kyonccc/zisaku/pcb/ergogen/footprints/ceoloide/README.md

# ceoloide/ergogen-footprints から取り込んだ部品（MIT ライセンスのみ）

出典: https://github.com/ceoloide/ergogen-footprints （コミット 36a24f5）
ライセンス: MIT（LICENSE-MIT を参照）。販売する製品にも使える。

| ファイル | 用途 |
| --- | --- |
| rotary_encoder_ec11_ec12.js | ロータリーエンコーダー（EC11/EC12） |

> 同じ部品集には Choc スイッチ・nice!view・電源スイッチもあるが、それらは
> **CC-BY-NC-SA-4.0（非営利）** のため kataware では使わず、`../kataware/` に自作したものを使う。
