kyonccc/zisaku/docs/concept/ukishima-ball-19.png

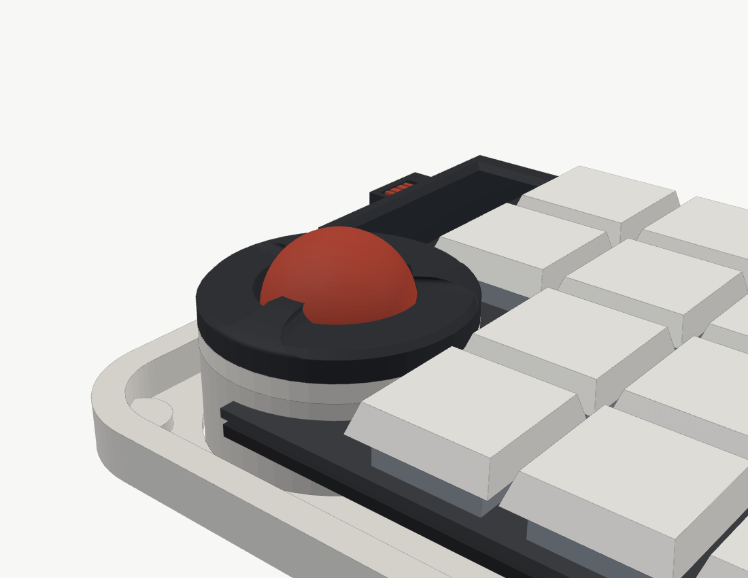
docs/concept/ukishima-ball-19.png
