kyonccc/zisaku/docs/concept/ukishima-ball-34.png

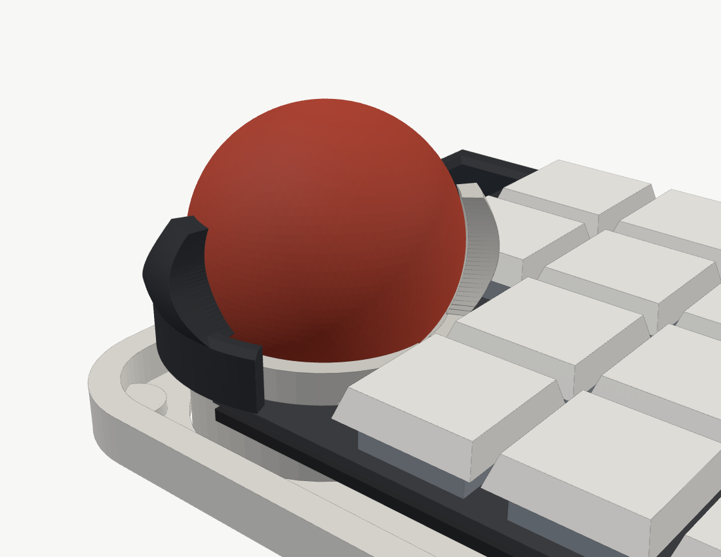
docs/concept/ukishima-ball-34.png
