kyonccc/zisaku/docs/concept/ukishima-ball-side.png

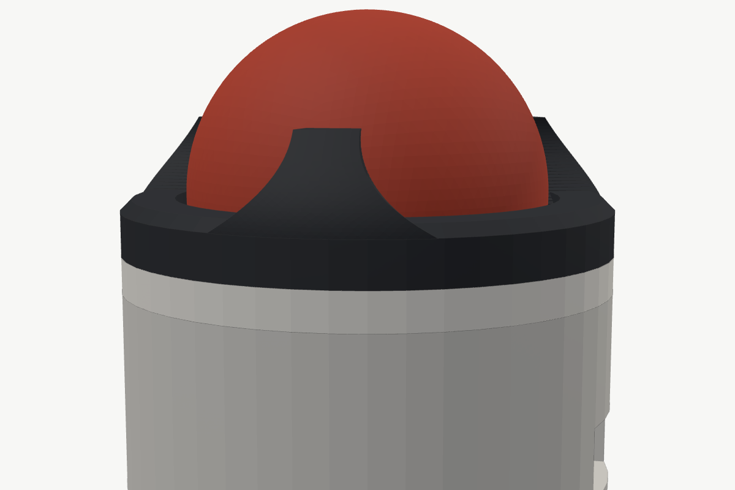
docs/concept/ukishima-ball-side.png
