kyonccc/zisaku/docs/concept/ukishima-screen.png

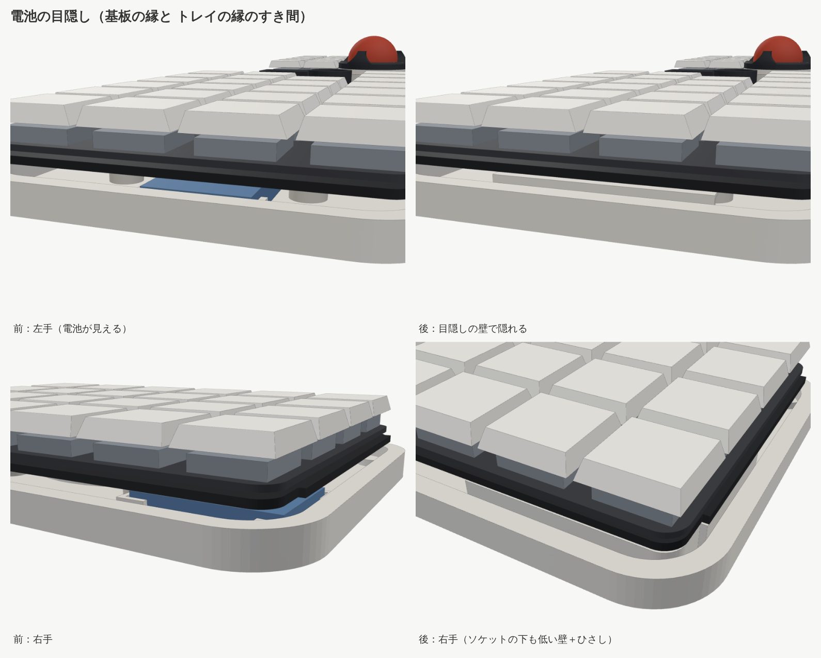
docs/concept/ukishima-screen.png
