kyonccc/zisaku/docs/concept/ukishima-top3d.png

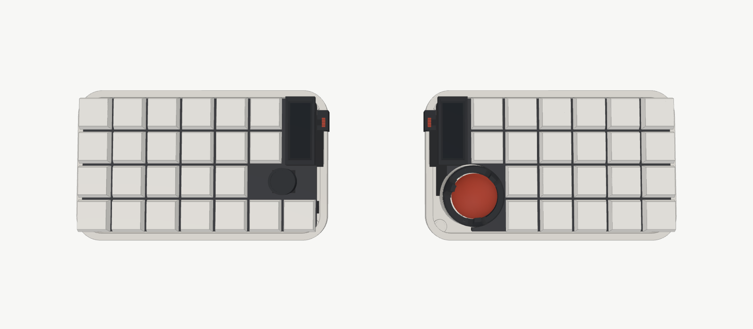
docs/concept/ukishima-top3d.png
