kyonccc/zisaku/docs/concept/ukishima-v1-exploded.png

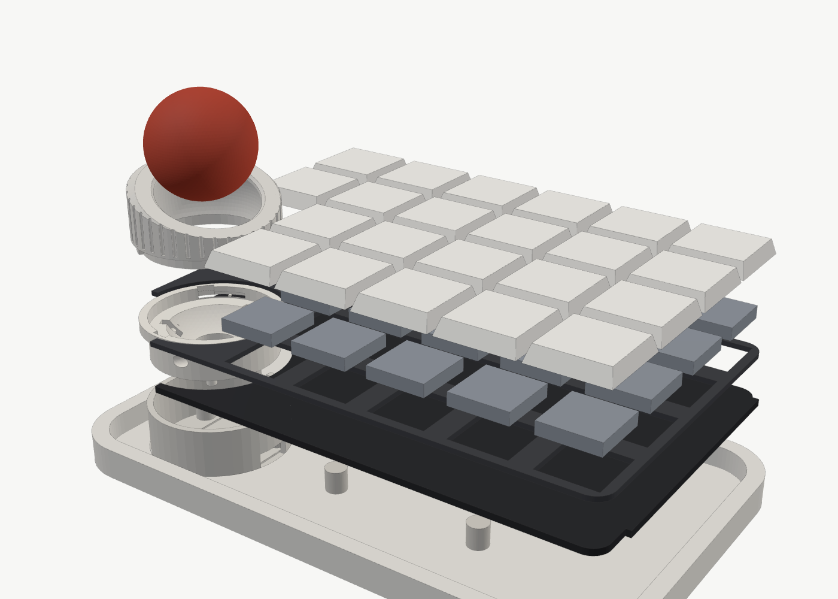
docs/concept/ukishima-v1-exploded.png
