kyonccc/zisaku/docs/concept/ukishima-v1-side.png

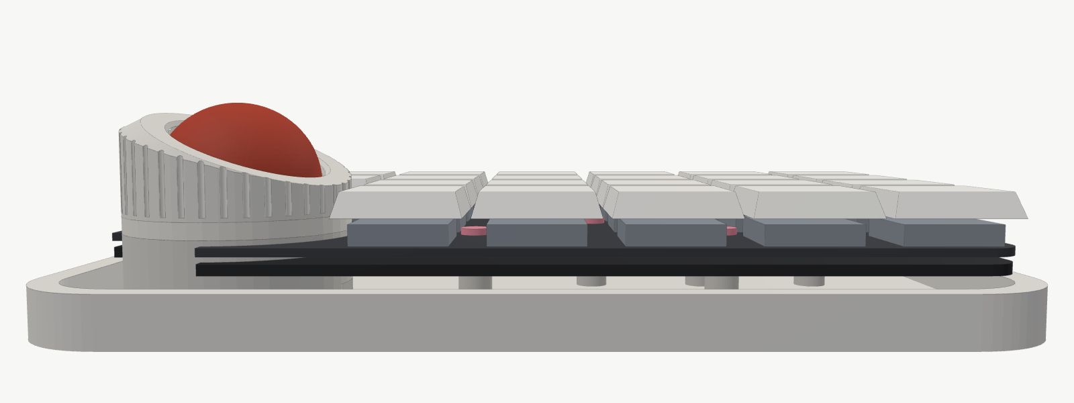
docs/concept/ukishima-v1-side.png
