kyonccc/zisaku/docs/images/ball-60deg-compare.png

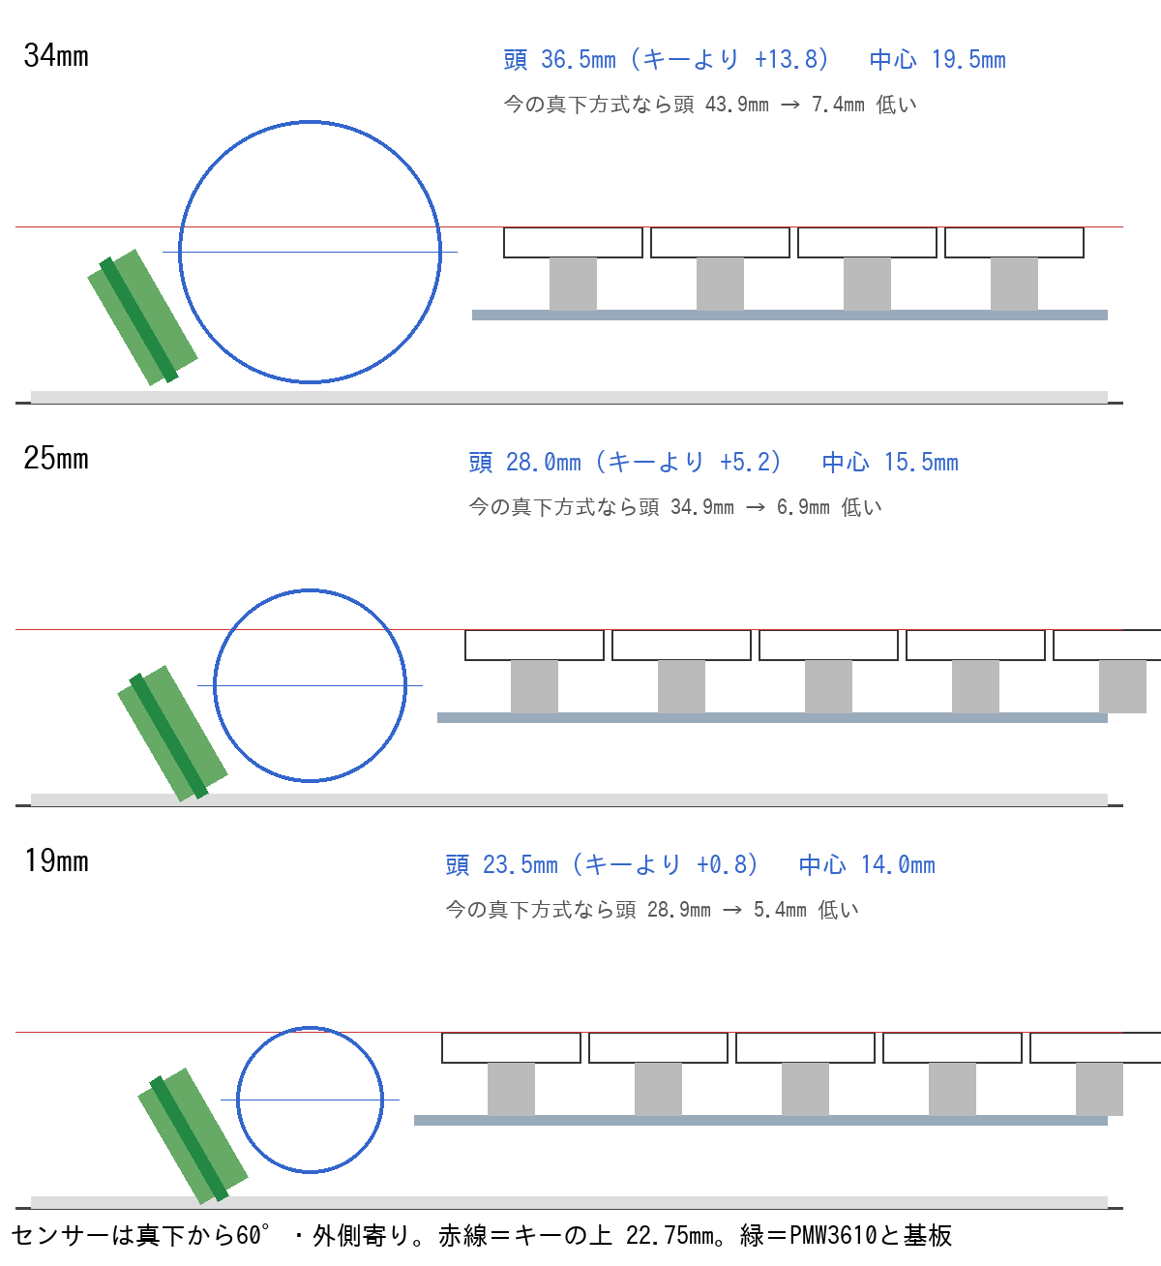
docs/images/ball-60deg-compare.png
