kyonccc/zisaku/docs/images/ball-case-34.png

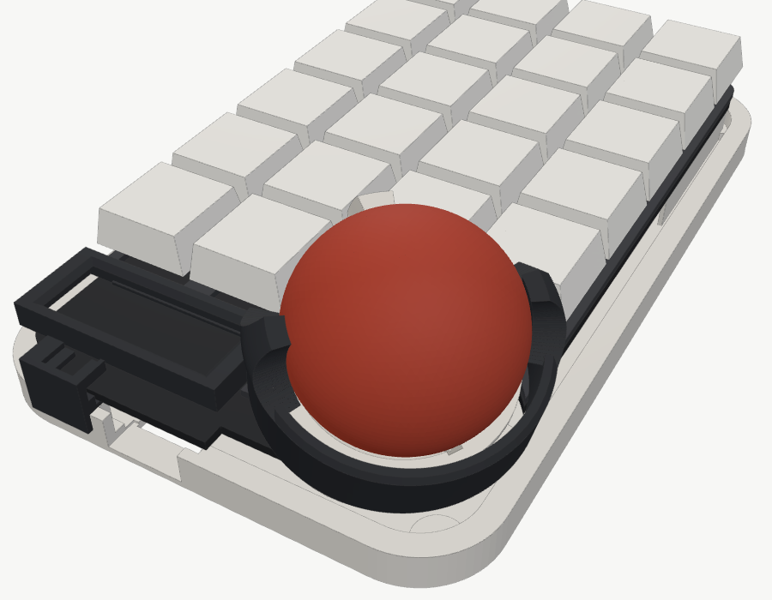
docs/images/ball-case-34.png
