kyonccc/zisaku/docs/images/ball-case-fillet.png

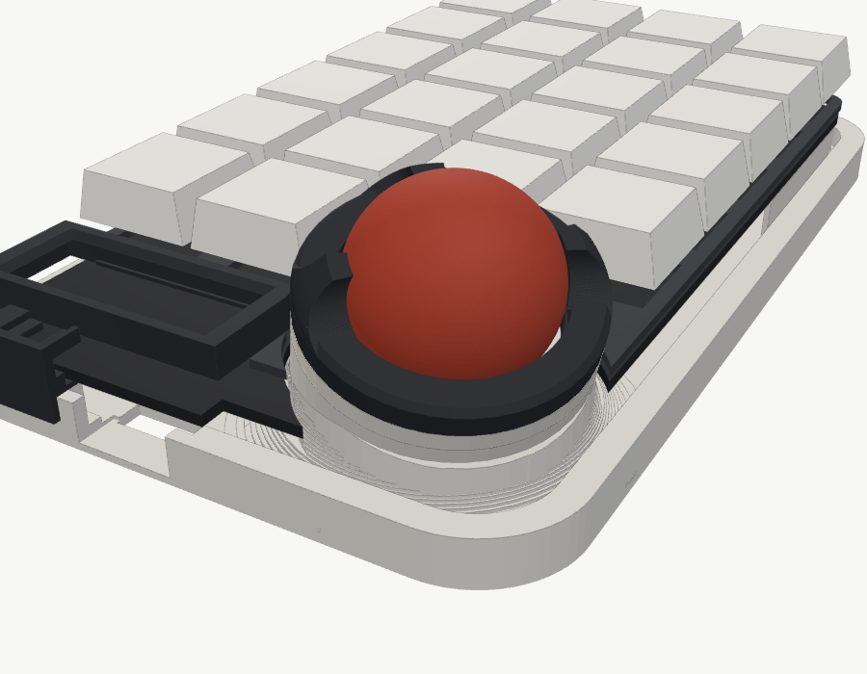
docs/images/ball-case-fillet.png
