kyonccc/zisaku/docs/images/ball-case-new.png

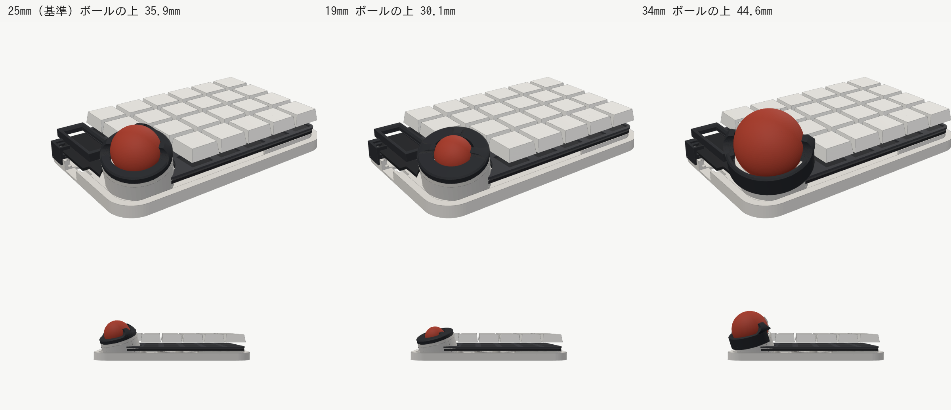
docs/images/ball-case-new.png
