kyonccc/zisaku/docs/images/ball-design-options.png

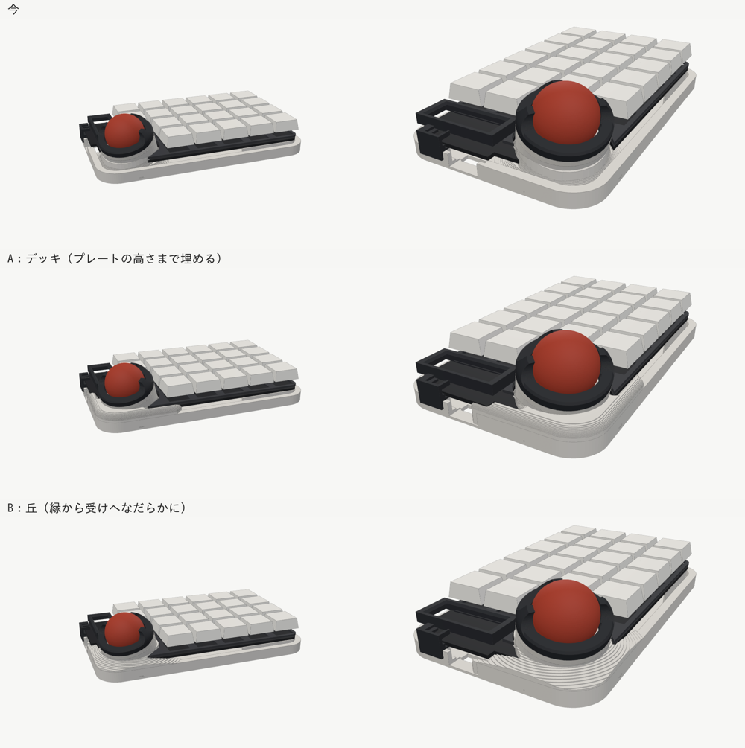
docs/images/ball-design-options.png
