kyonccc/zisaku/docs/images/ball-front-tilt.png

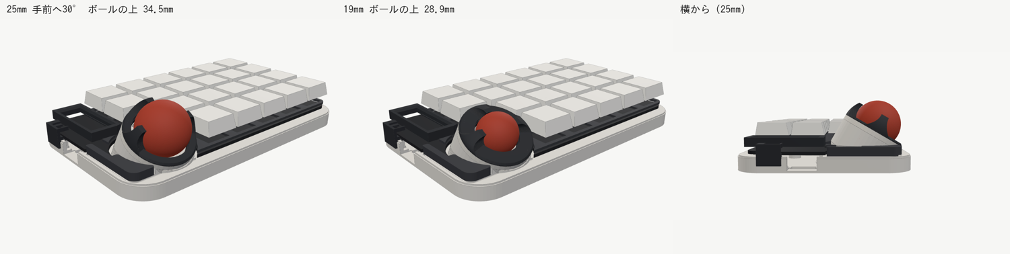
docs/images/ball-front-tilt.png
