kyonccc/zisaku/docs/images/ball-low-rings.png

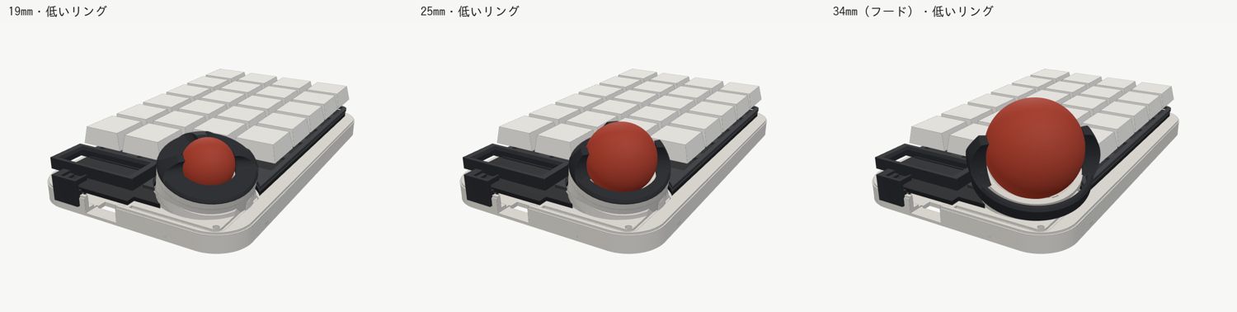
docs/images/ball-low-rings.png
