kyonccc/zisaku/docs/images/ball-tilt-20-30-40.png

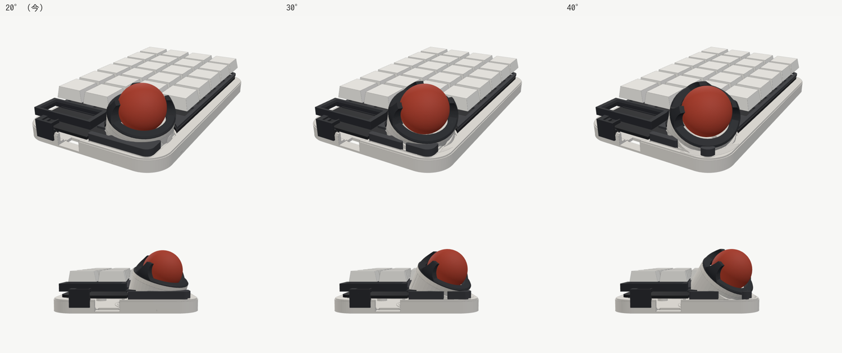
docs/images/ball-tilt-20-30-40.png
