kyonccc/zisaku/docs/images/ball-tilt-30-vs-0.png

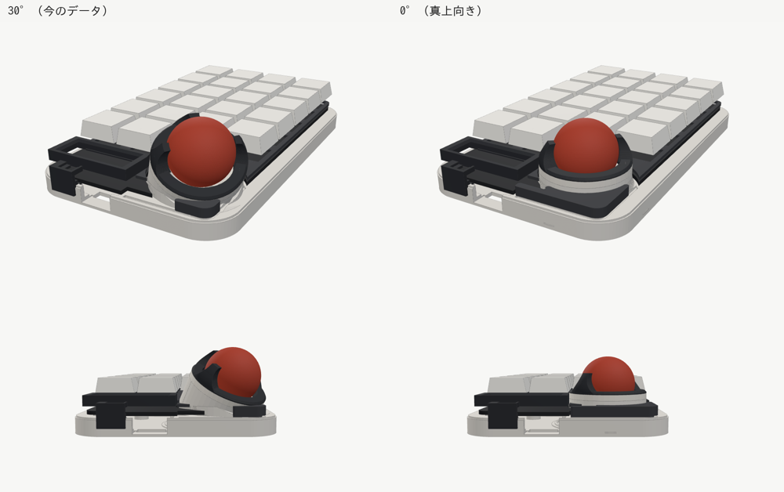
docs/images/ball-tilt-30-vs-0.png
