kyonccc/zisaku/docs/images/case-bottom.png

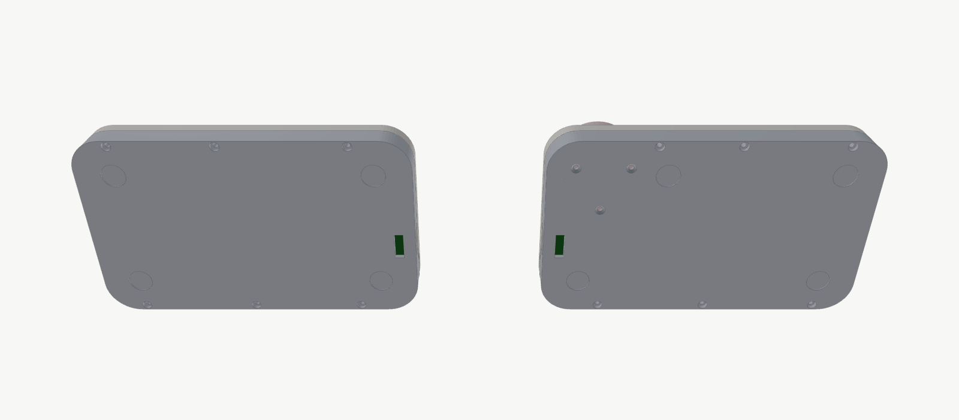
docs/images/case-bottom.png
