kyonccc/zisaku/docs/images/case-exploded-right.png

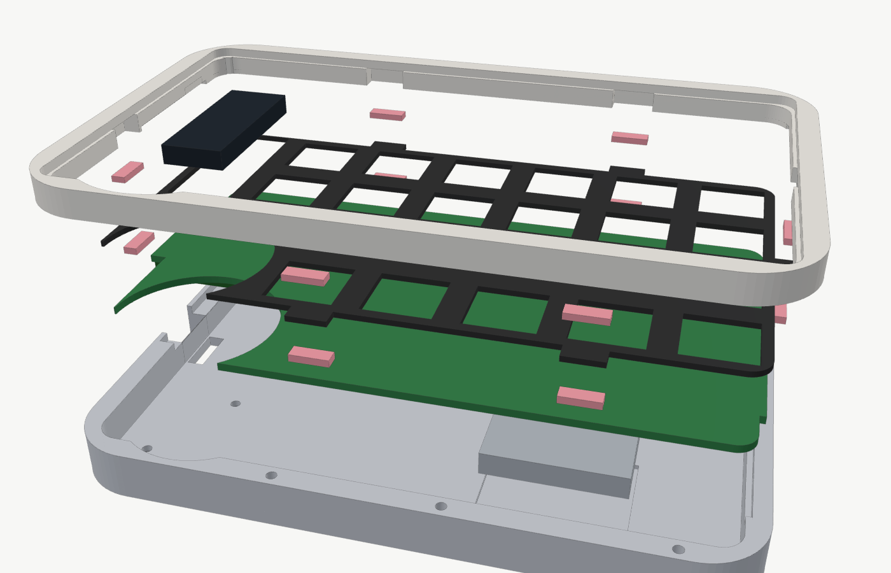
docs/images/case-exploded-right.png
