kyonccc/zisaku/docs/images/concept-ball-module.png

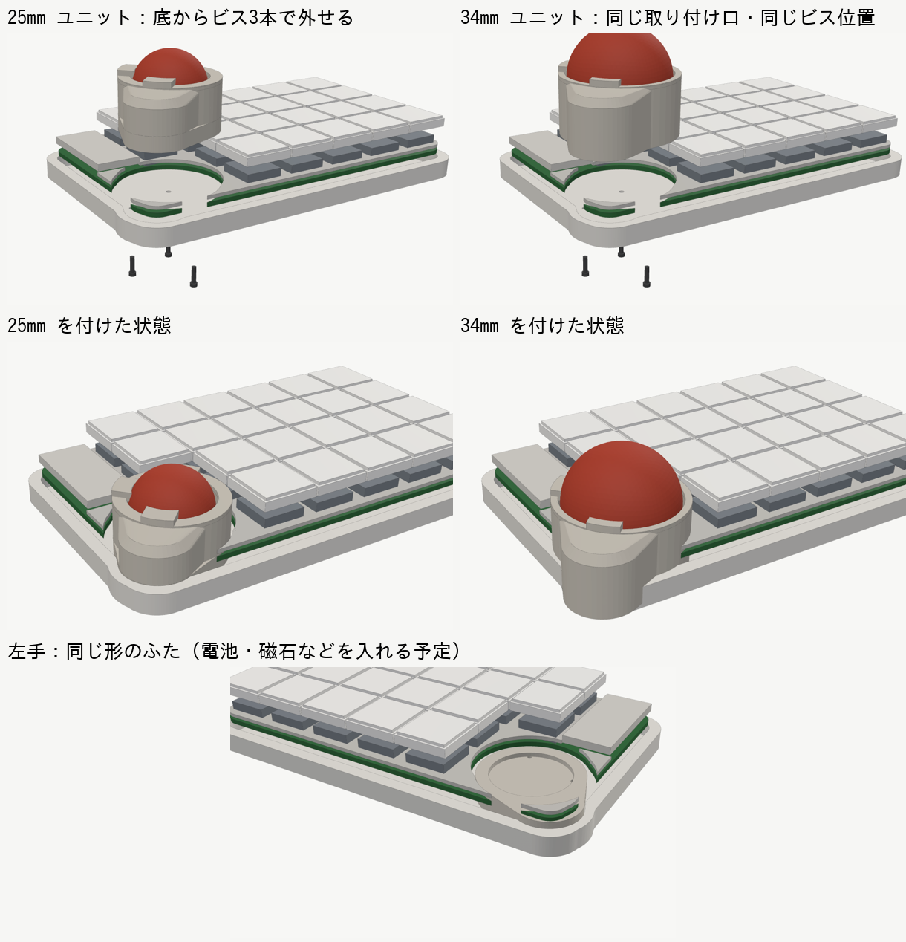
docs/images/concept-ball-module.png
