kyonccc/zisaku/docs/images/concept-cup-screws.png

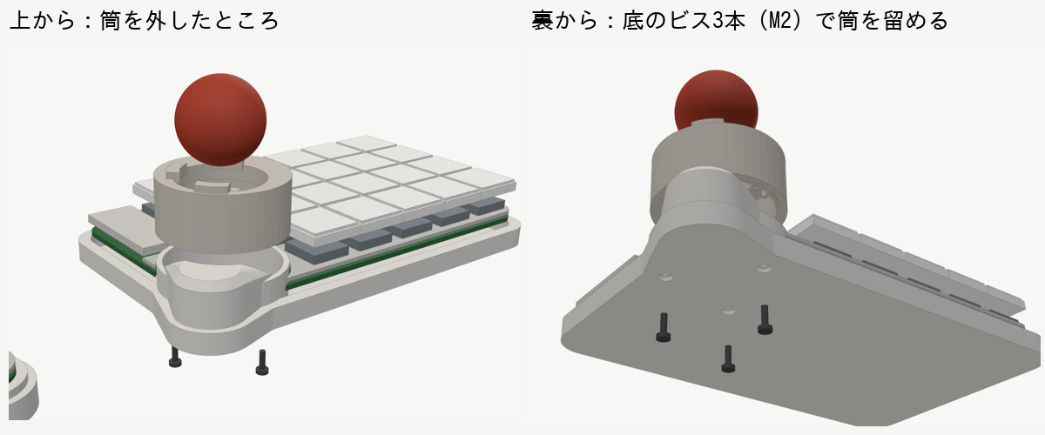
docs/images/concept-cup-screws.png
