kyonccc/zisaku/docs/images/concept-cup-swap.png

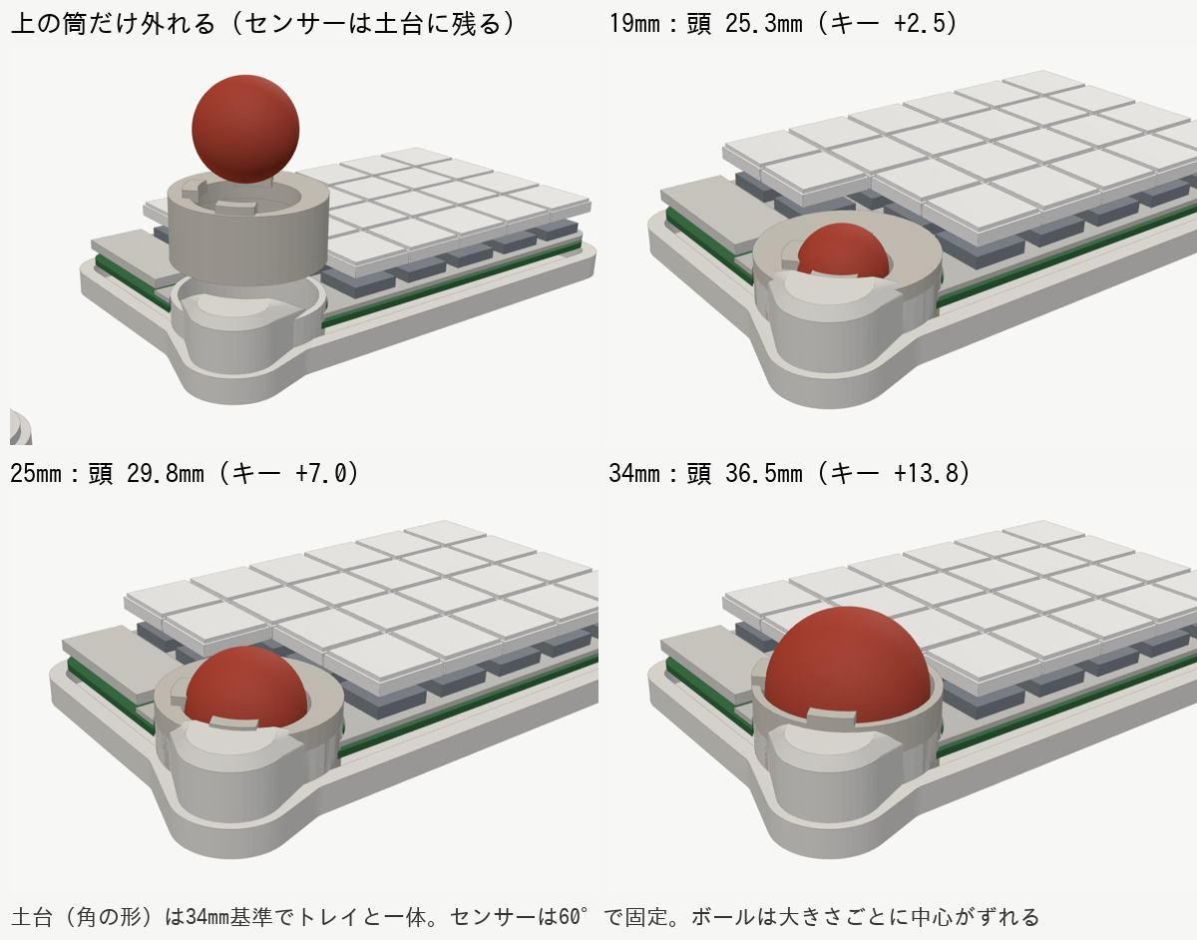
docs/images/concept-cup-swap.png
