kyonccc/zisaku/docs/images/concept-left-wheel.png

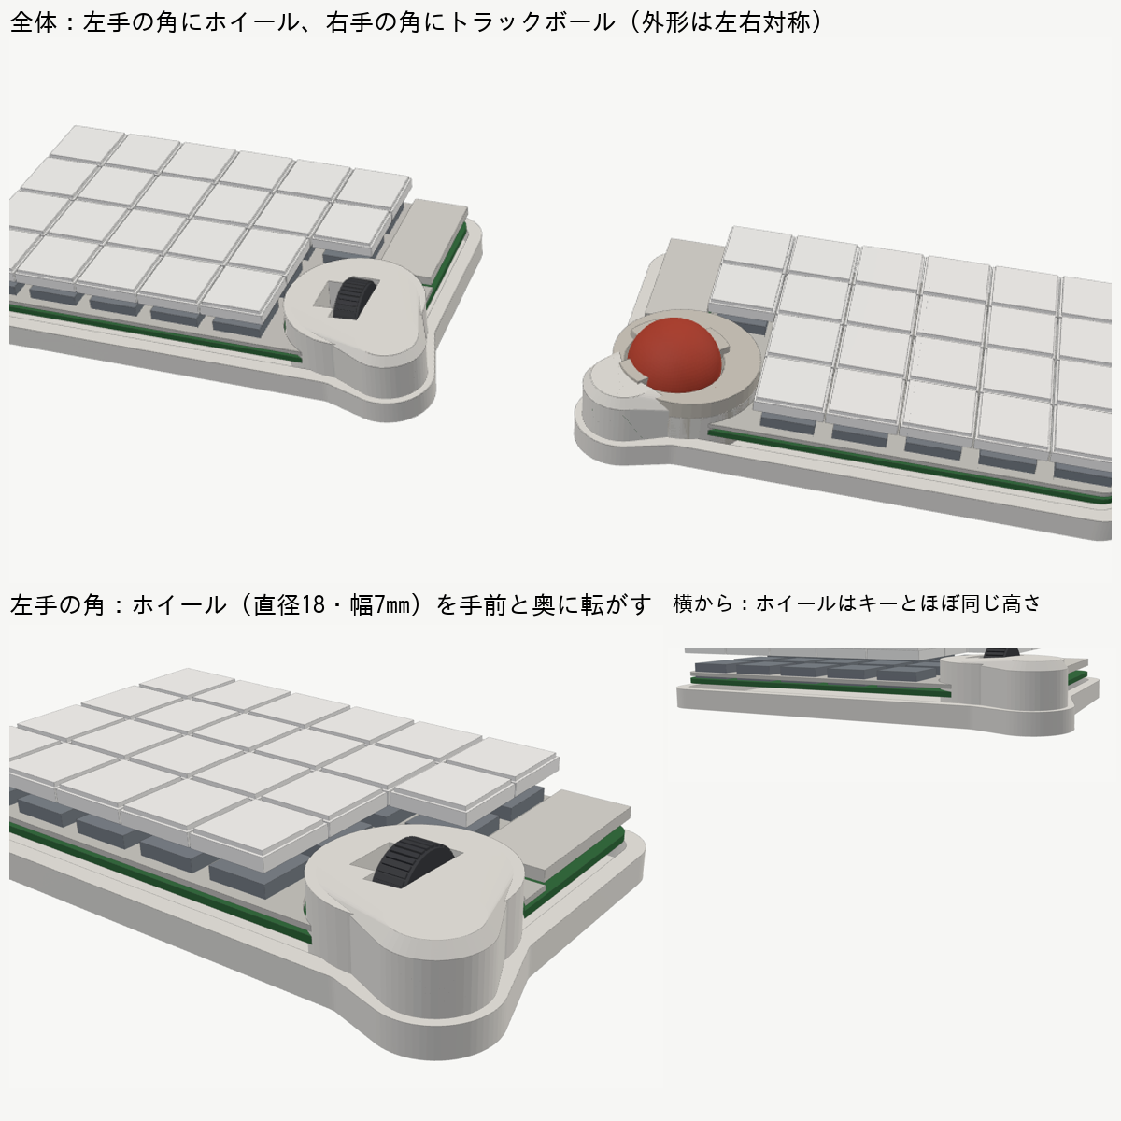
docs/images/concept-left-wheel.png
