kyonccc/zisaku/docs/images/concept-mcu-top.png

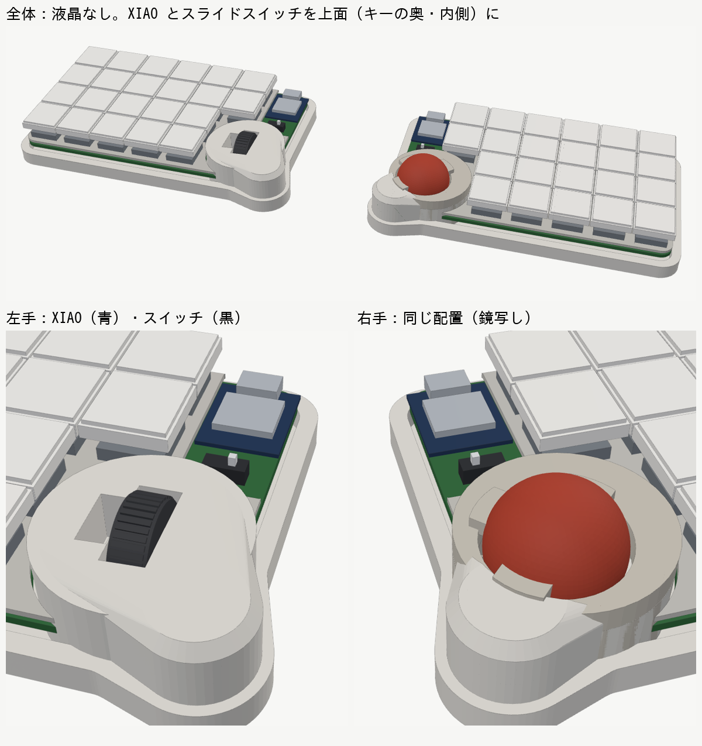
docs/images/concept-mcu-top.png
