kyonccc/zisaku/docs/images/concept-ortho-60deg-34.png

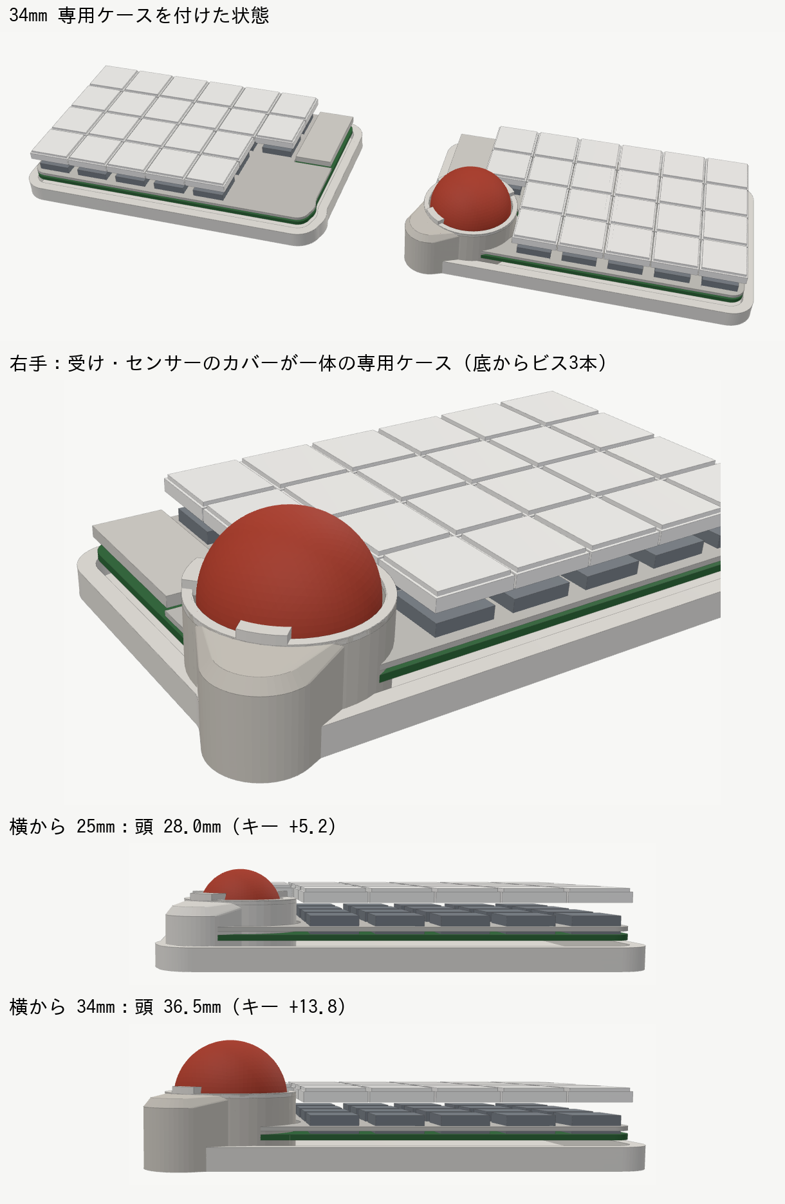
docs/images/concept-ortho-60deg-34.png
