kyonccc/zisaku/docs/images/concept-ortho-60deg.png

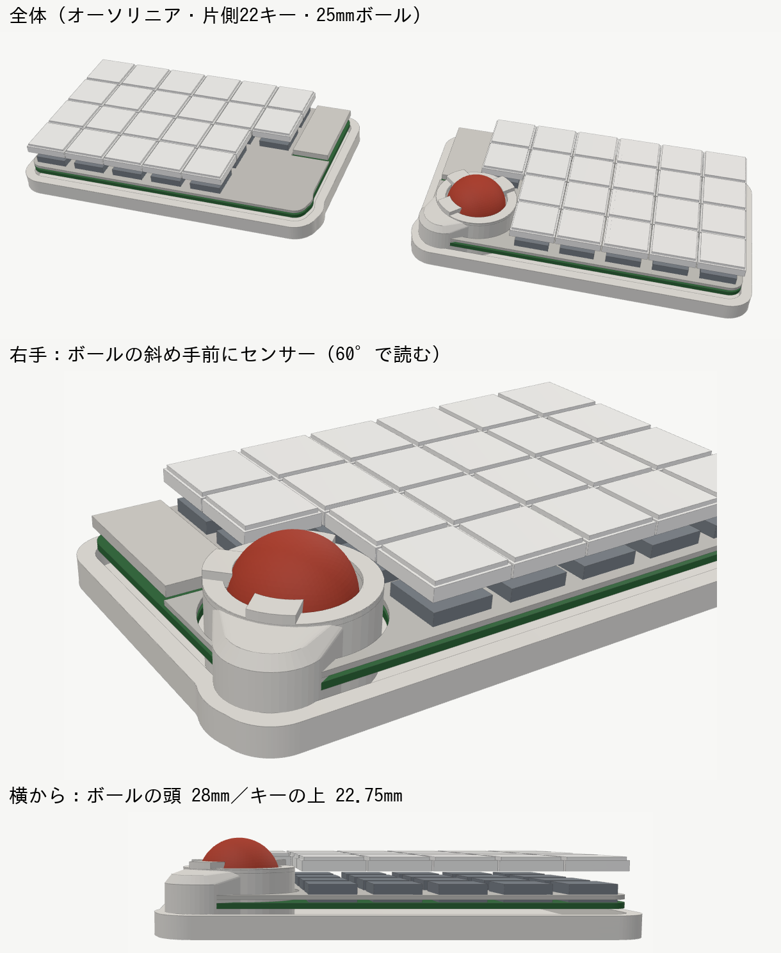
docs/images/concept-ortho-60deg.png
