kyonccc/zisaku/docs/images/concept-tray-small.png

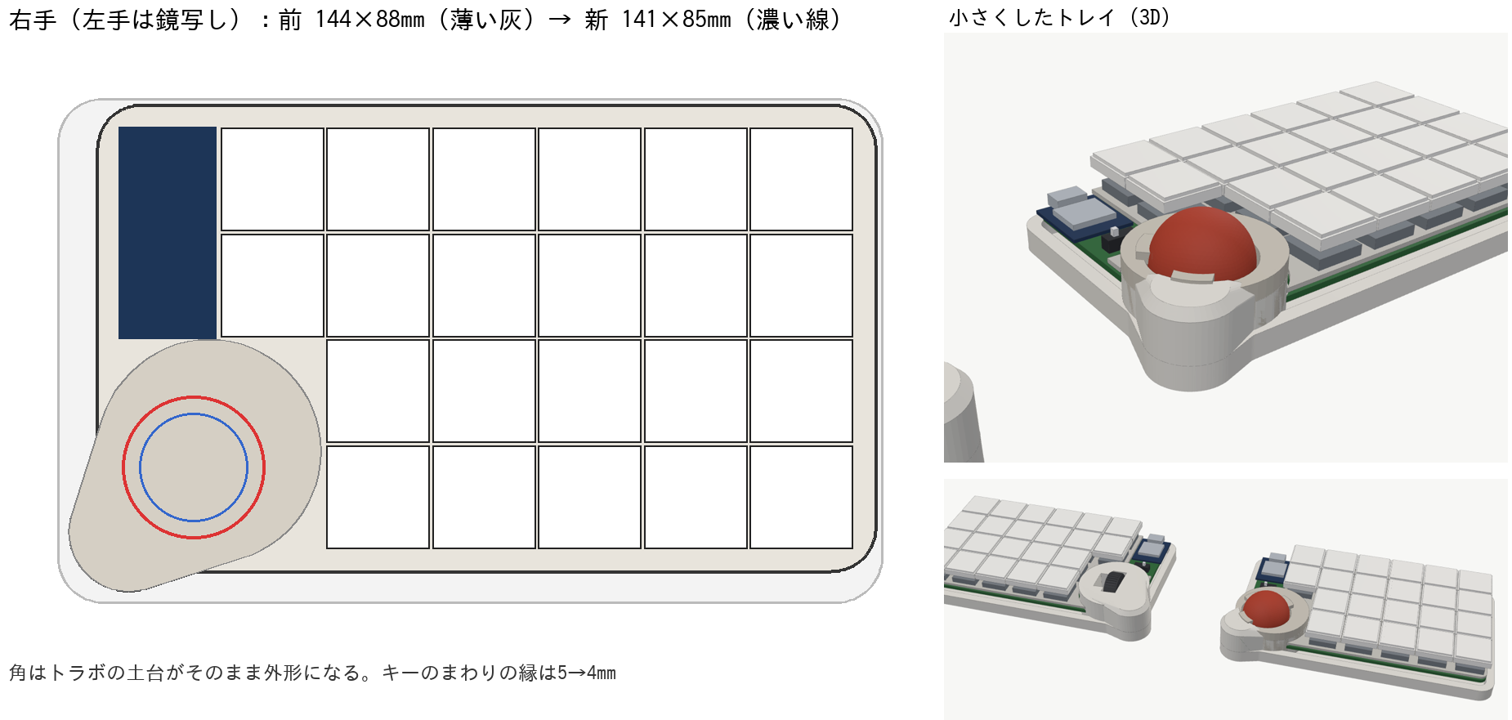
docs/images/concept-tray-small.png
