kyonccc/zisaku/docs/images/controller-section.png

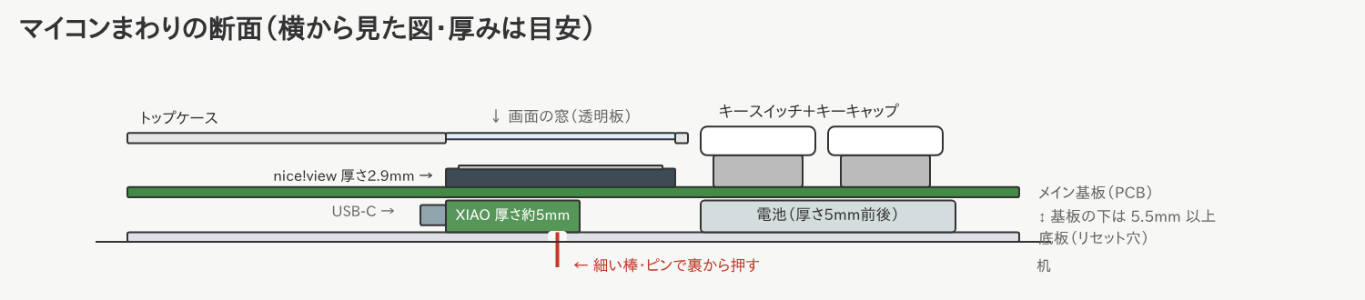
docs/images/controller-section.png
