kyonccc/zisaku/docs/images/controller-top.png

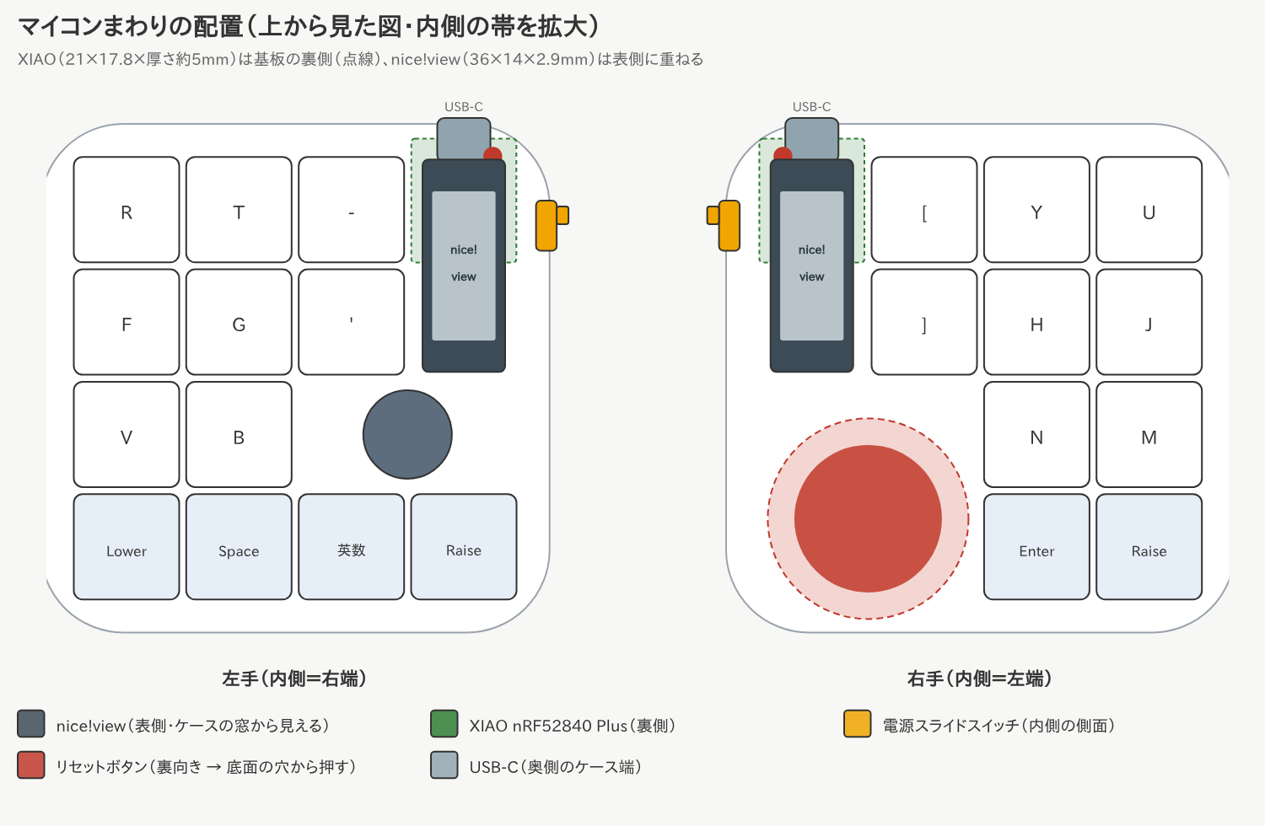
docs/images/controller-top.png
