kyonccc/zisaku/docs/images/island-ball.png

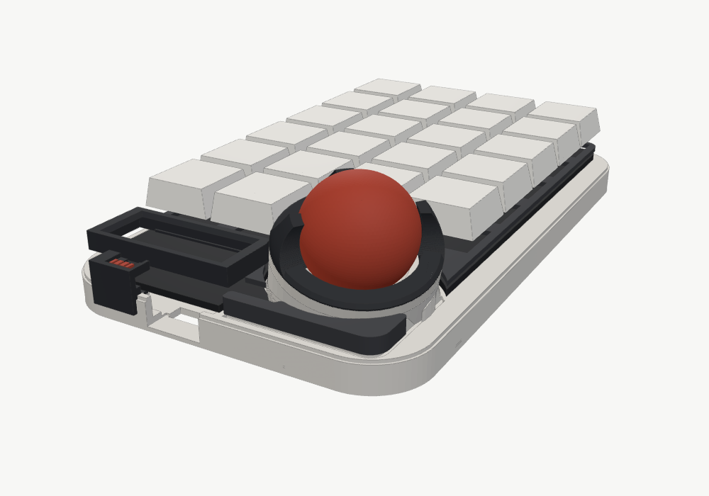
docs/images/island-ball.png
