kyonccc/zisaku/docs/images/island-overview.png

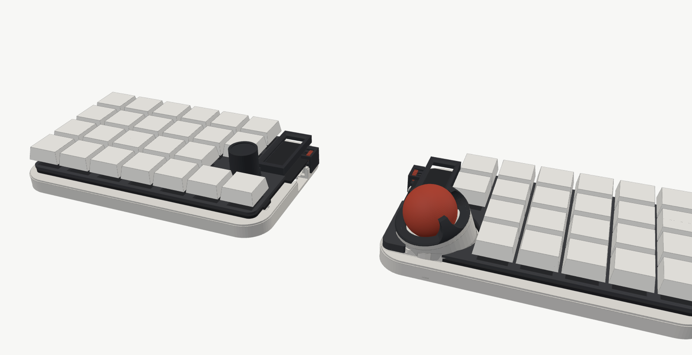
docs/images/island-overview.png
