kyonccc/zisaku/docs/images/island-side.png

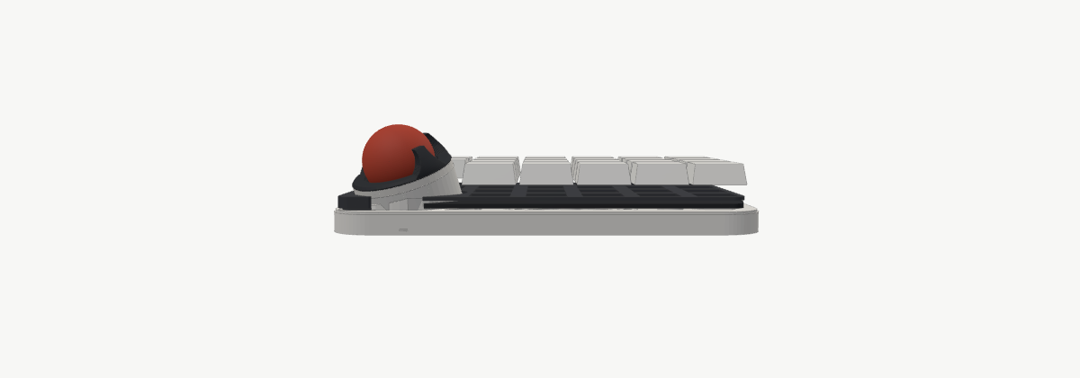
docs/images/island-side.png
