kyonccc/zisaku/docs/images/layout-d-candidates.png

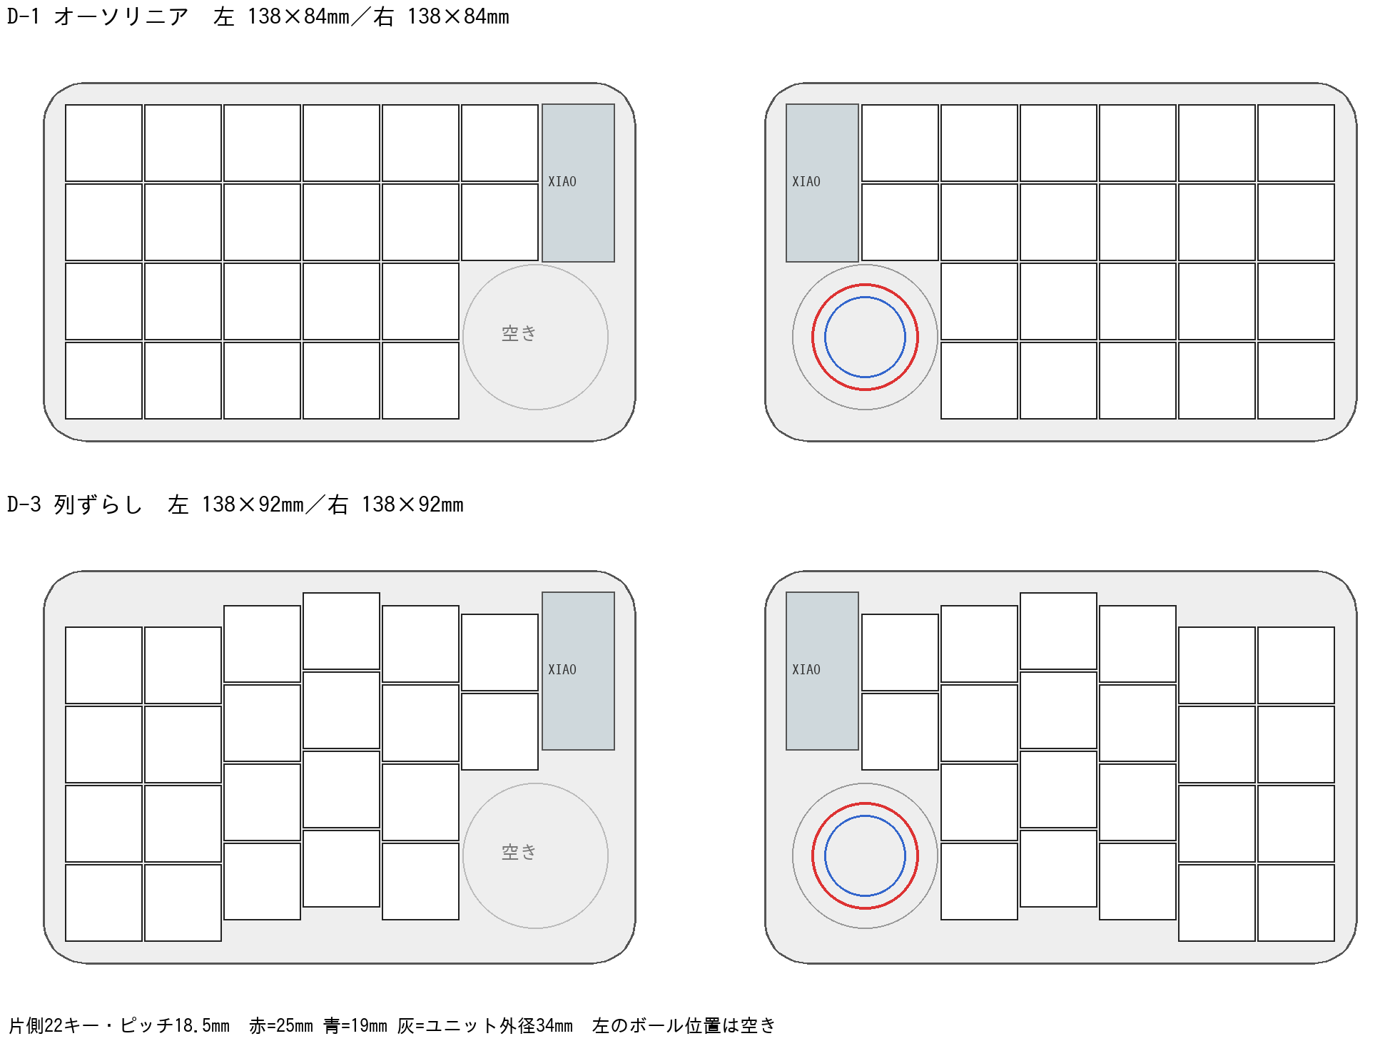
docs/images/layout-d-candidates.png
