kyonccc/zisaku/docs/images/layout-plan1.png

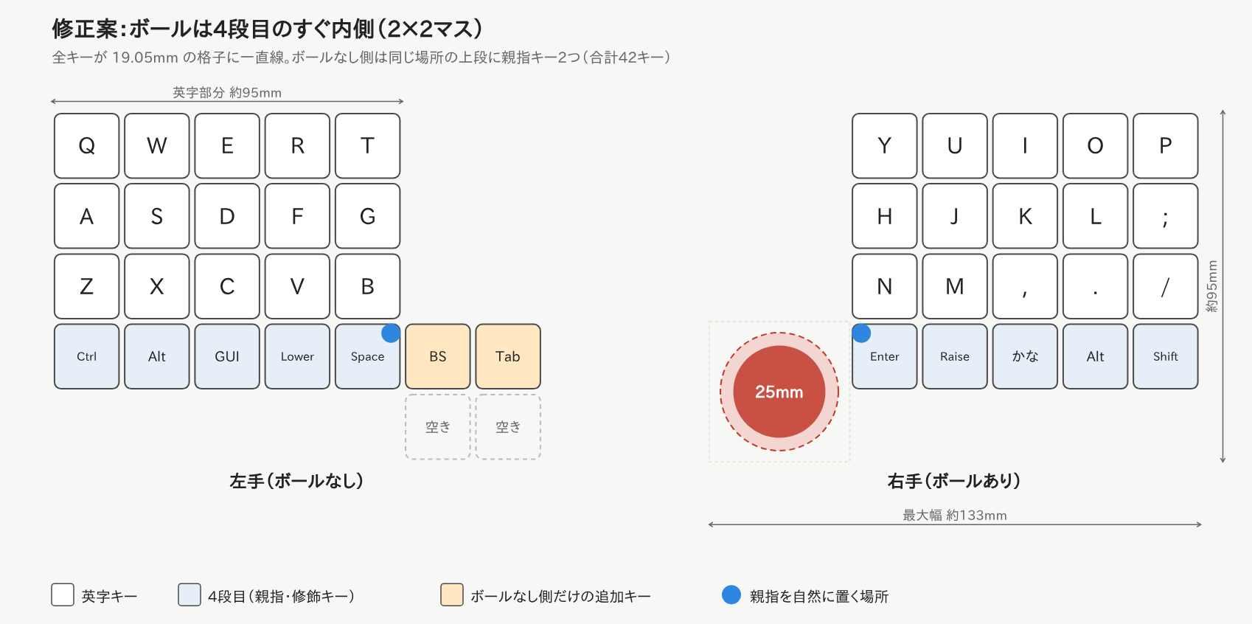
docs/images/layout-plan1.png
