kyonccc/zisaku/docs/images/layout-plan2.png

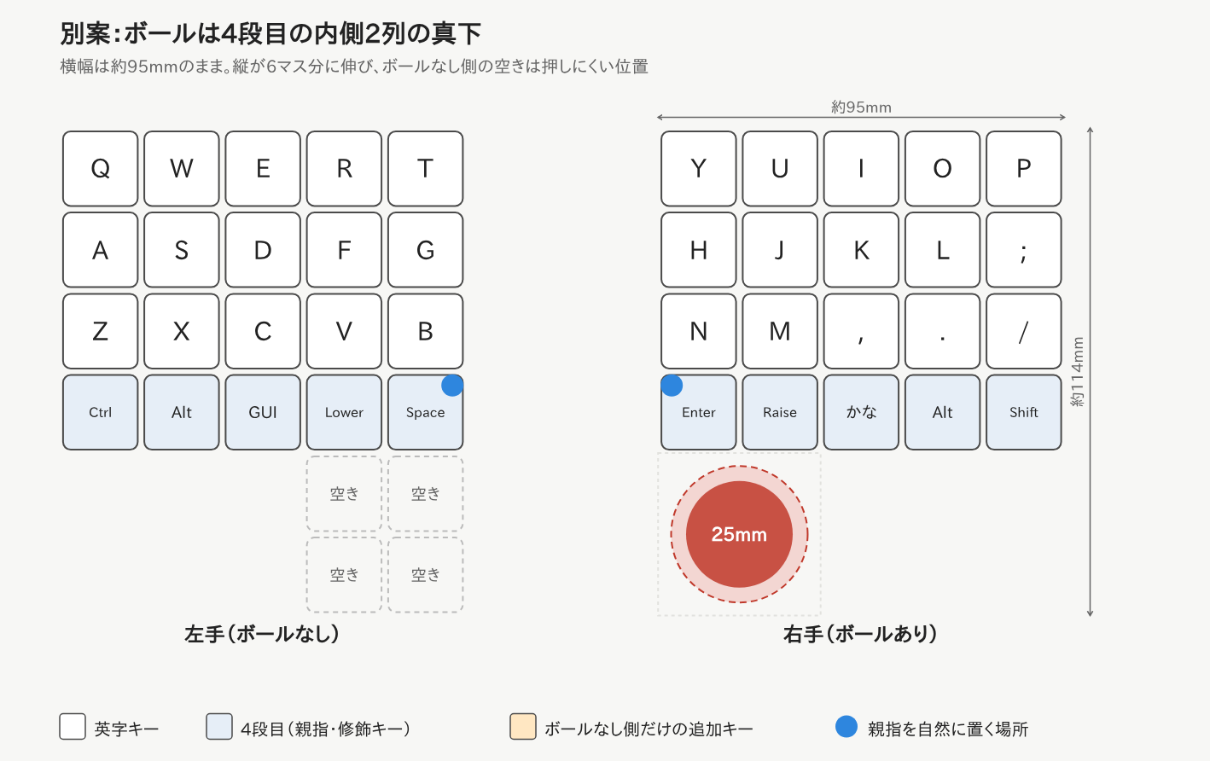
docs/images/layout-plan2.png
