kyonccc/zisaku/docs/images/layout-tidy.png

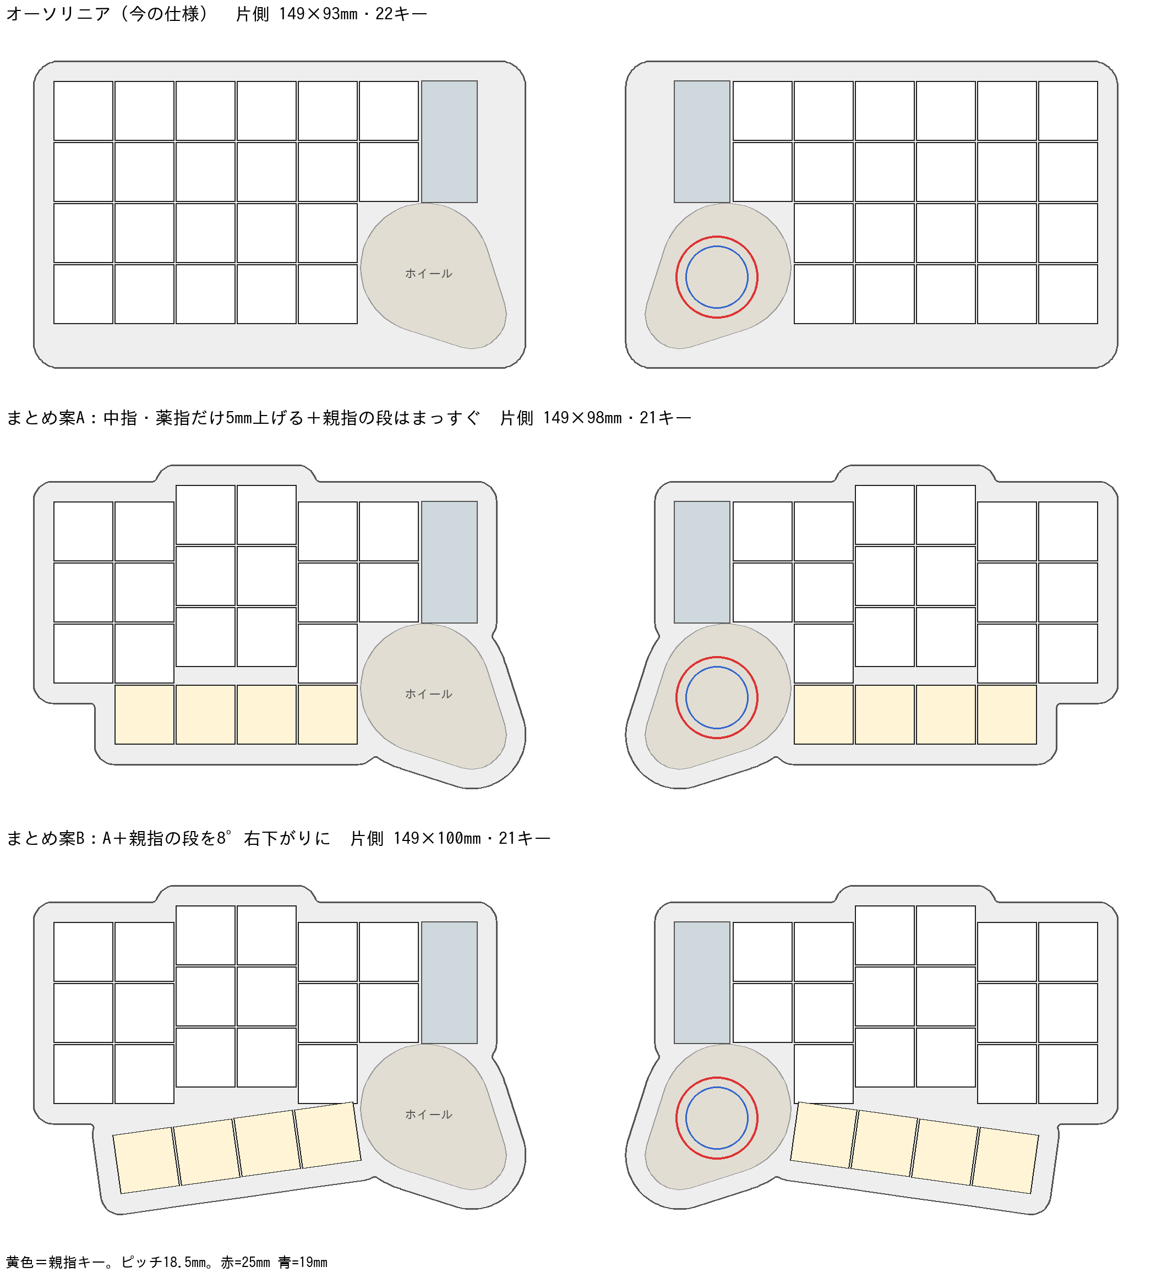
docs/images/layout-tidy.png
