kyonccc/zisaku/docs/images/left-options.png

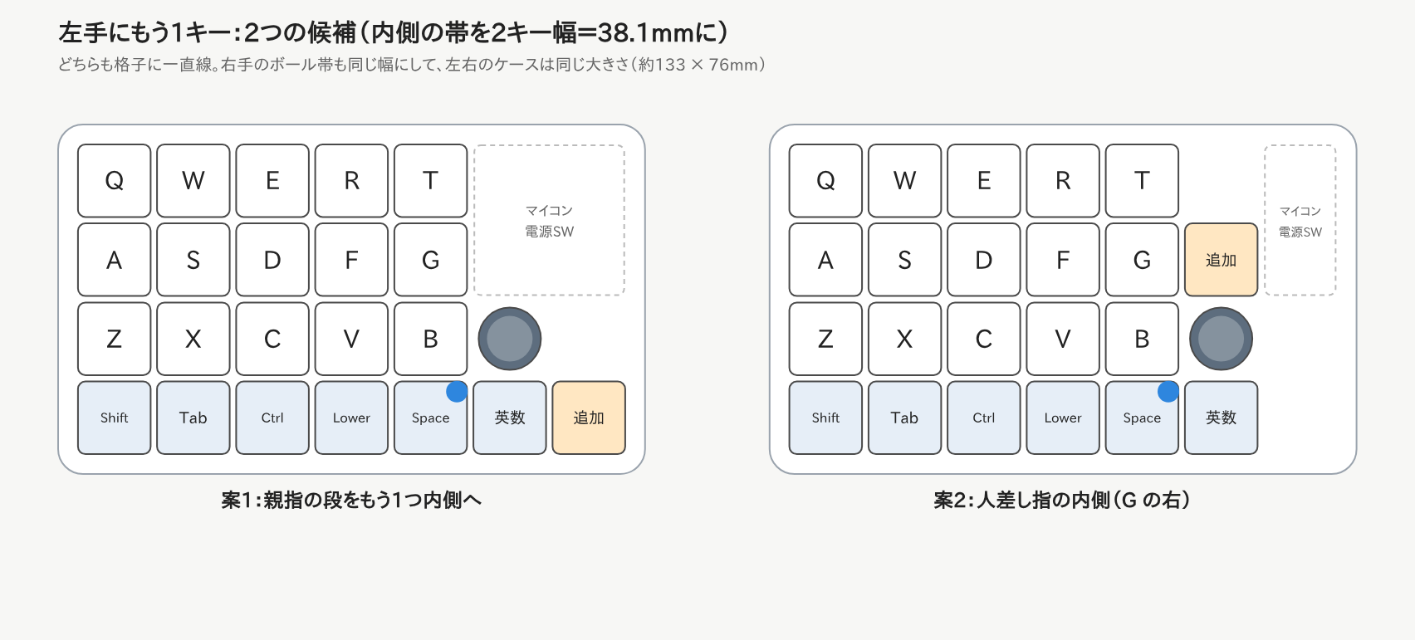
docs/images/left-options.png
