kyonccc/zisaku/docs/images/pcb-left-now.png

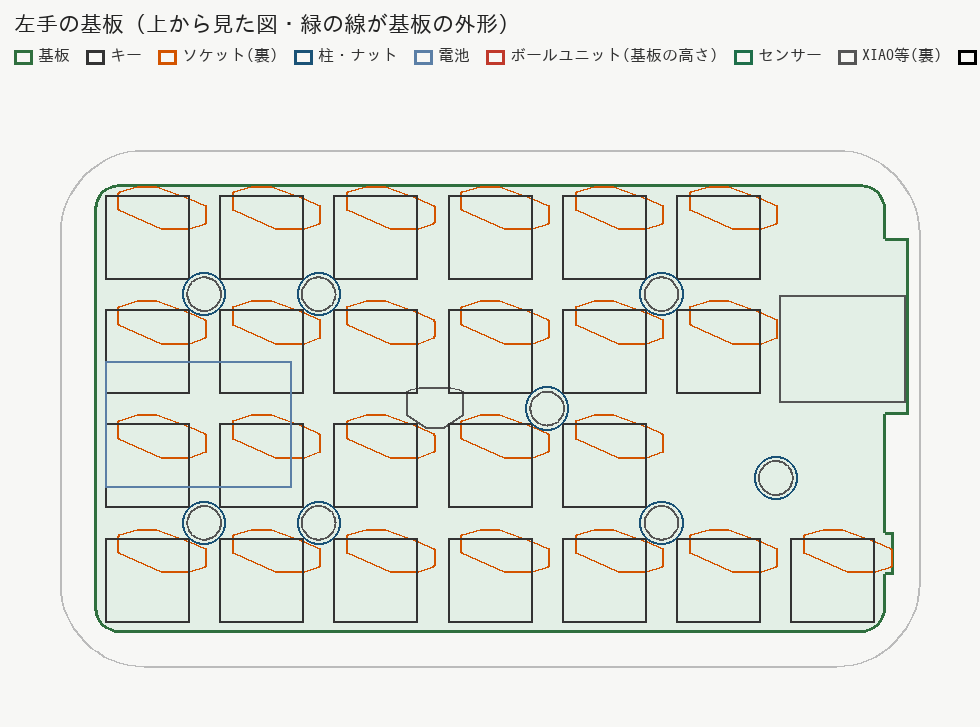
docs/images/pcb-left-now.png
