kyonccc/zisaku/docs/images/pcb-now.png

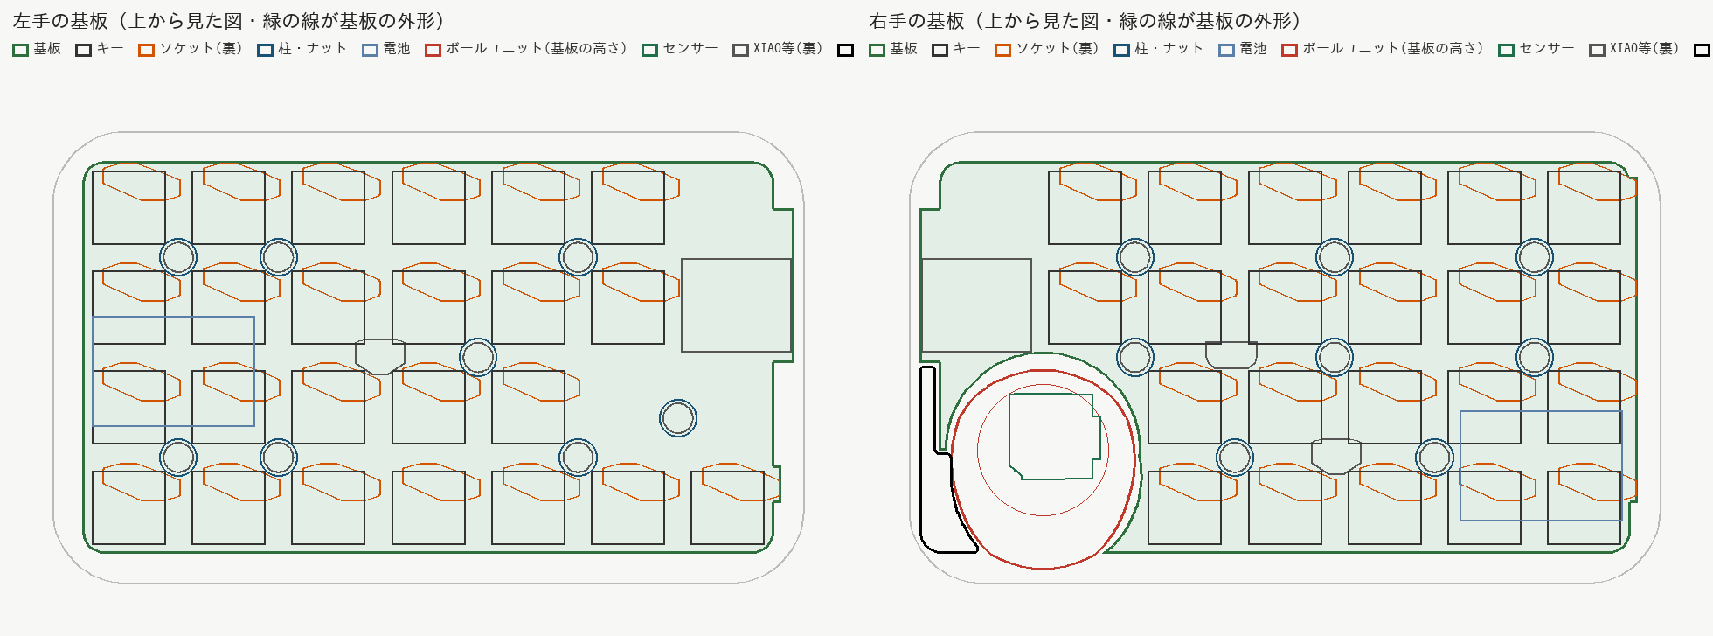
docs/images/pcb-now.png
