kyonccc/zisaku/docs/images/pcb-right-now.png

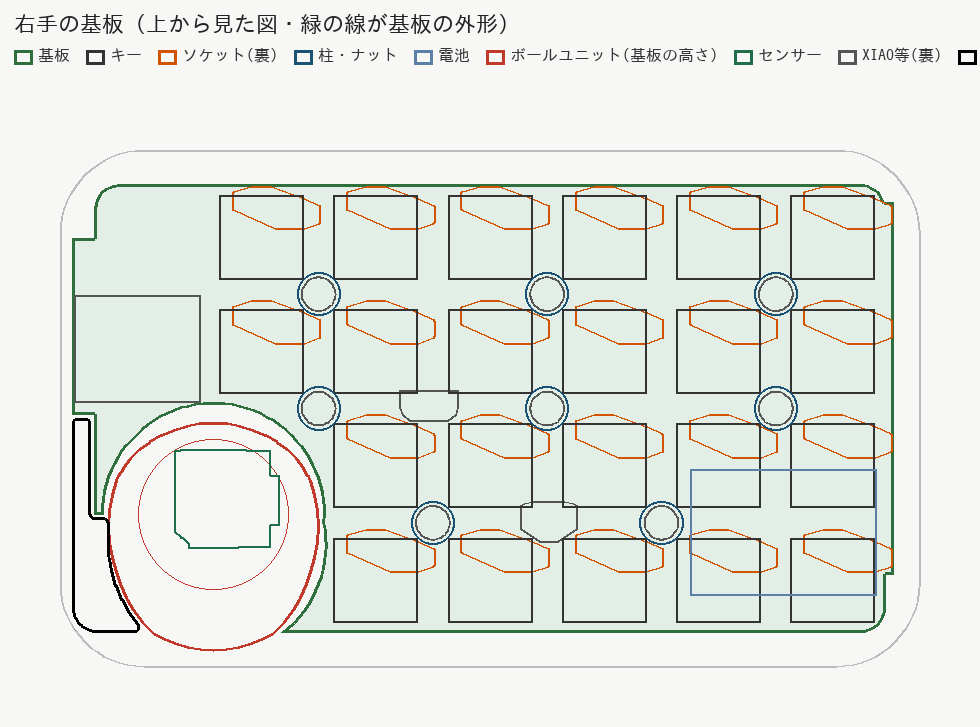
docs/images/pcb-right-now.png
