kyonccc/zisaku/docs/images/proposal-ball-in-grid.png

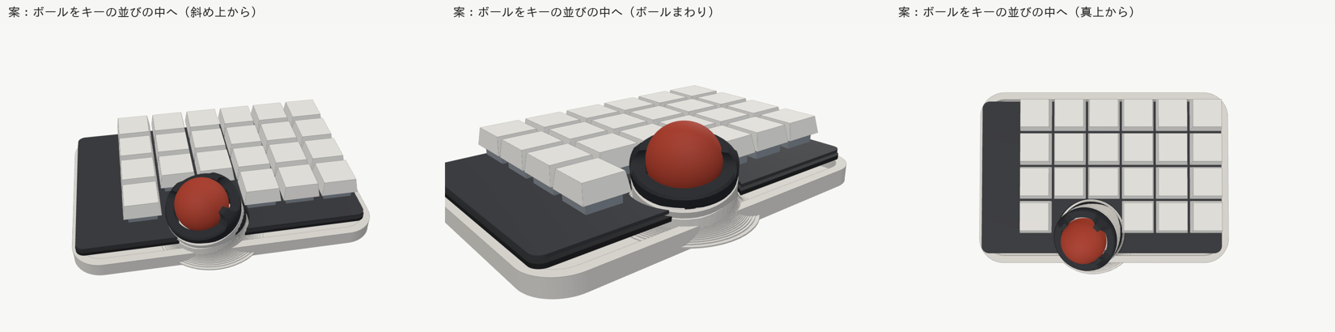
docs/images/proposal-ball-in-grid.png
