kyonccc/zisaku/docs/images/rim-vs-island.png

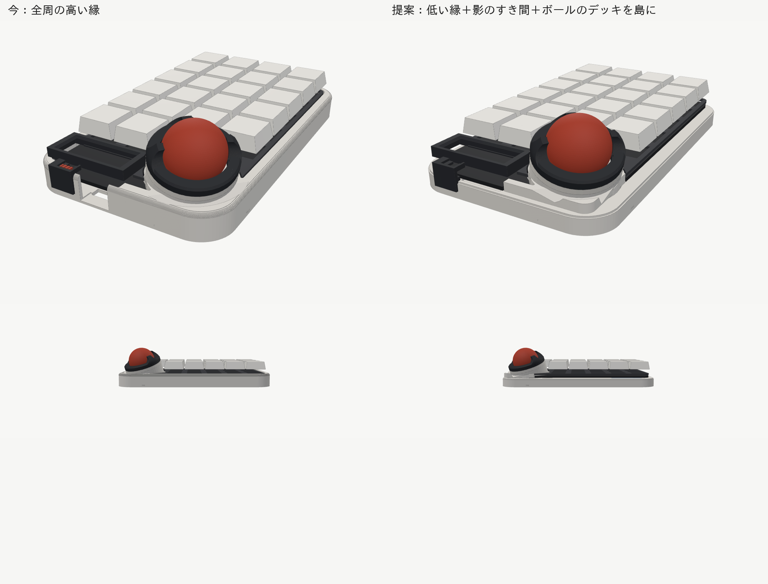
docs/images/rim-vs-island.png
