kyonccc/zisaku/docs/images/ball-case-parts.png

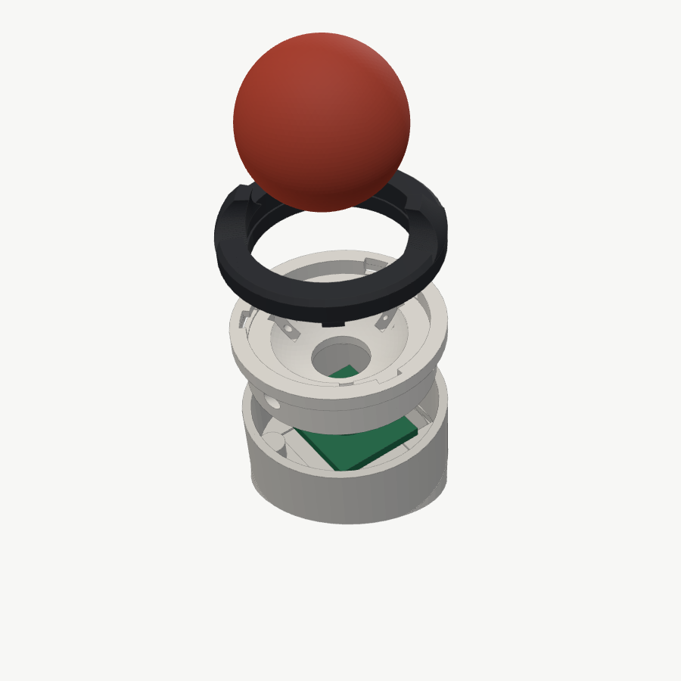
docs/images/ball-case-parts.png
