kyonccc/zisaku/case/stl/ball_cup_25.stl

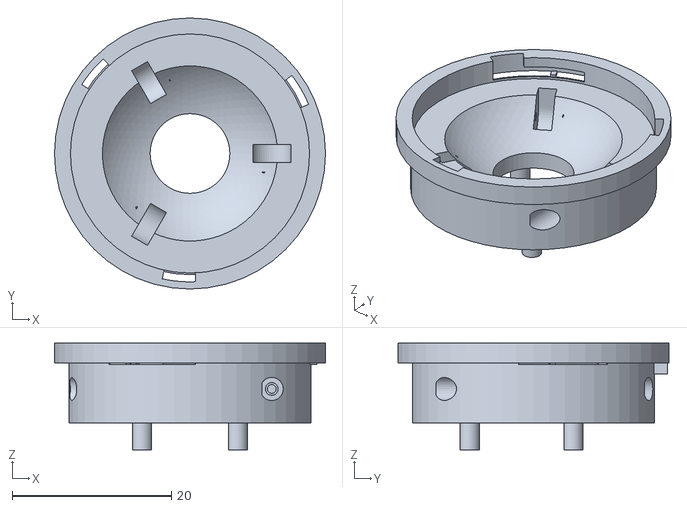
[picture p78: CAD file, 2026-10-19]
case/stl/ball_cup_25.stl
34.0 x 34.0 x 13.4
