kyonccc/zisaku/case/stl/mock/mock_ball_19.stl

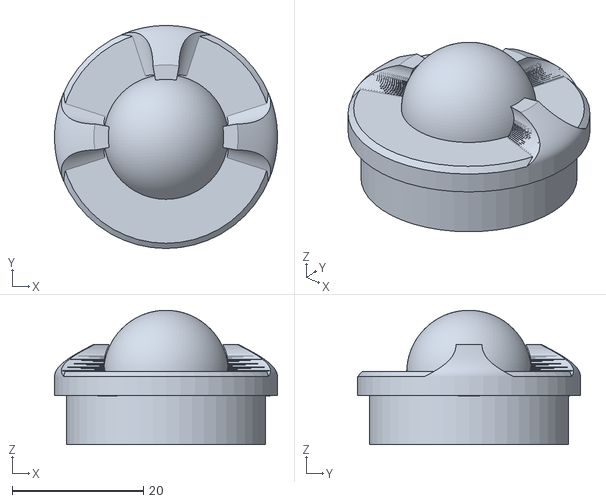
[picture p79: CAD file, 2026-10-21]
case/stl/mock/mock_ball_19.stl
34.0 x 34.0 x 20.5
