kyonccc/zisaku/case/stl/mock_tilt/mock_ball_25_tilt30.stl

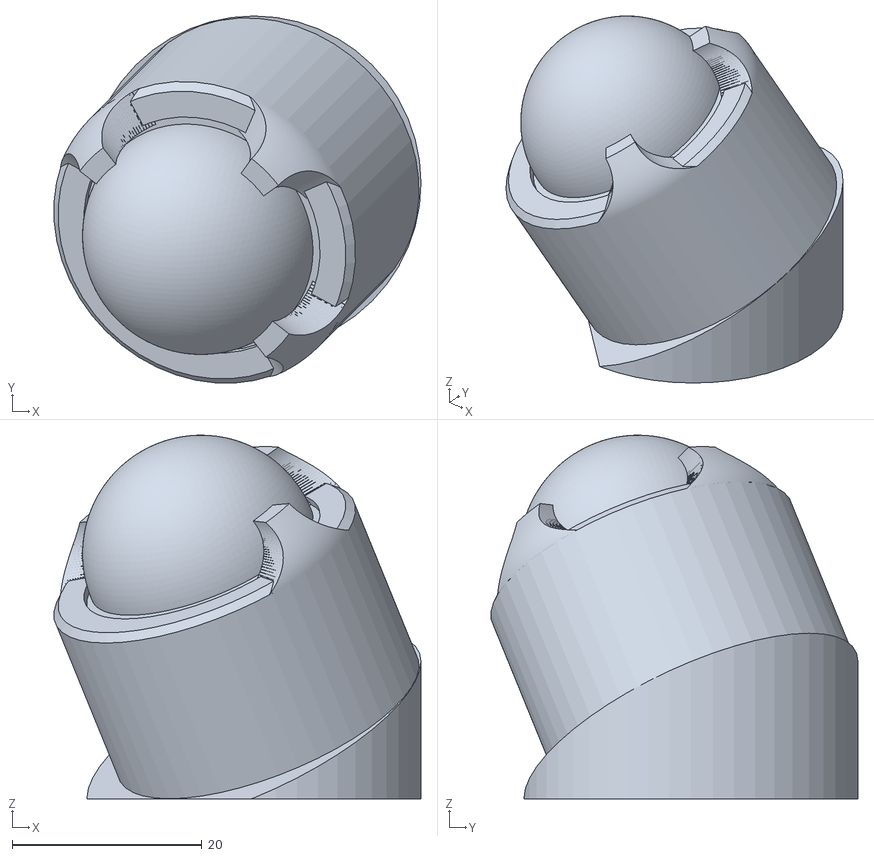
[picture p80: CAD file, 2026-10-20]
case/stl/mock_tilt/mock_ball_25_tilt30.stl
38.7 x 38.7 x 38.3
