kyonccc/zisaku/case/stl/mock_worst/mock_ball_25.stl

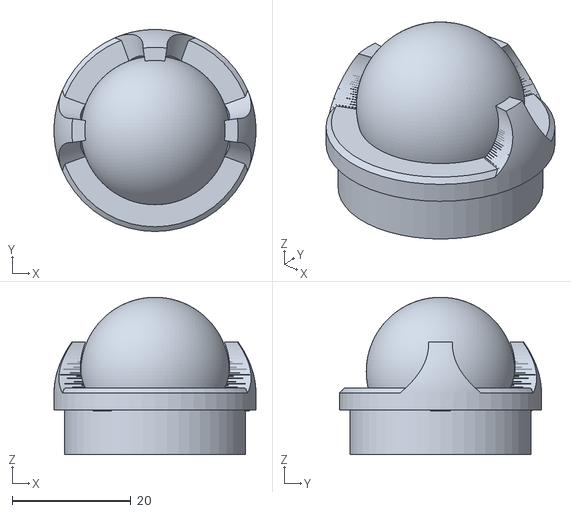
[picture p81: CAD file, 2026-10-21]
case/stl/mock_worst/mock_ball_25.stl
34.0 x 34.0 x 26.5
