kyonccc/zisaku/case/stl/ukishima/ball_cover_19.stl

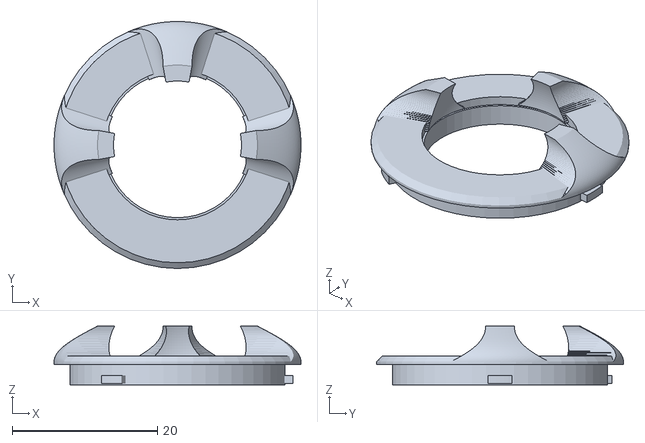
[picture p82: CAD file, 2026-10-21]
case/stl/ukishima/ball_cover_19.stl
34.0 x 34.0 x 8.11
