kyonccc/zisaku/pcb/ergogen/output/outlines/ball_cut.dxf

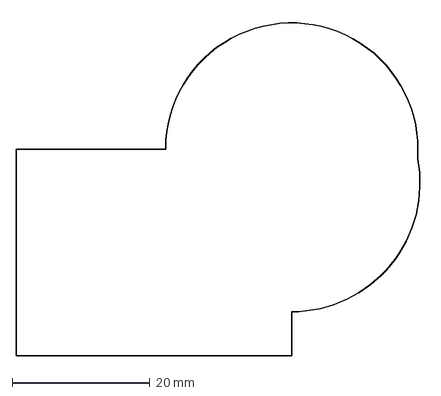
[picture p83: CAD file, 2026-10-21]
pcb/ergogen/output/outlines/ball_cut.dxf
59.3 x 49.3 mm
