kyonccc/zisaku/case/stl/ball_cup_19.stl

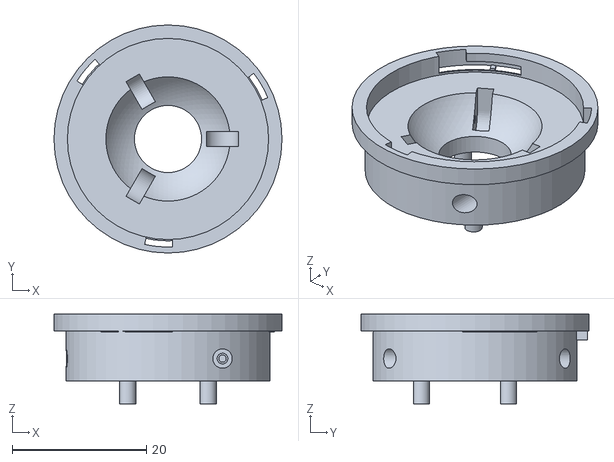
[picture p84: CAD file, 2026-10-19]
case/stl/ball_cup_19.stl
34.0 x 34.0 x 13.4
