kyonccc/zisaku/case/stl/mock/mock_tray_right.stl

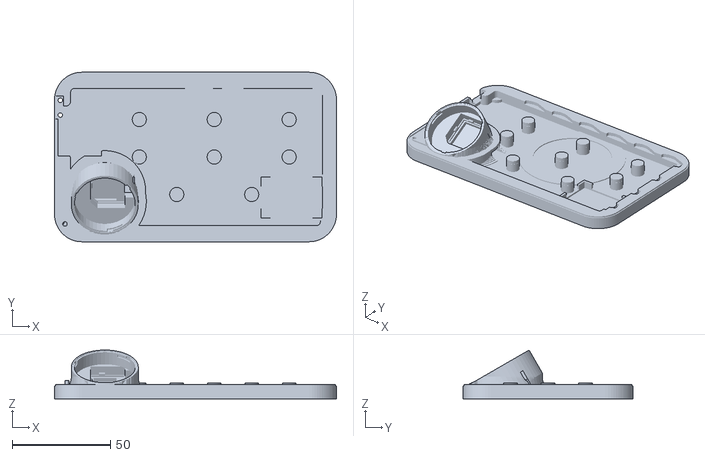
[picture p85: CAD file, 2026-10-21]
case/stl/mock/mock_tray_right.stl
143.4 x 86.2 x 24.9
