kyonccc/zisaku/case/stl/mock_tilt/mock_ball_25_tilt00.stl

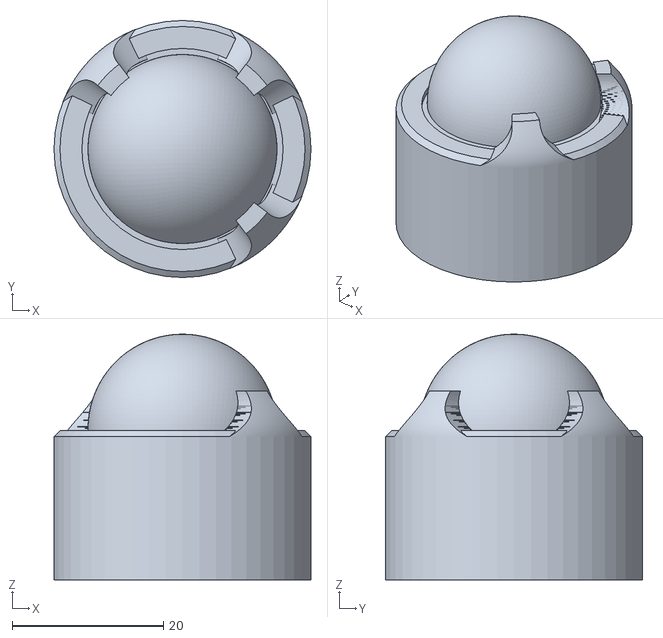
[picture p86: CAD file, 2026-10-20]
case/stl/mock_tilt/mock_ball_25_tilt00.stl
34.0 x 34.0 x 32.5
