kyonccc/zisaku/case/stl/ukishima/ball_cover_25.stl

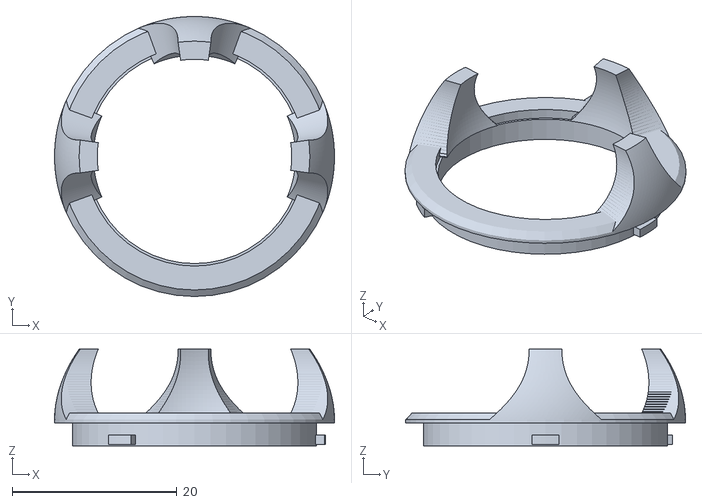
[picture p87: CAD file, 2026-10-21]
case/stl/ukishima/ball_cover_25.stl
34.0 x 34.0 x 11.8
