kyonccc/zisaku/pcb/ergogen/output/outlines/pcb_right.dxf

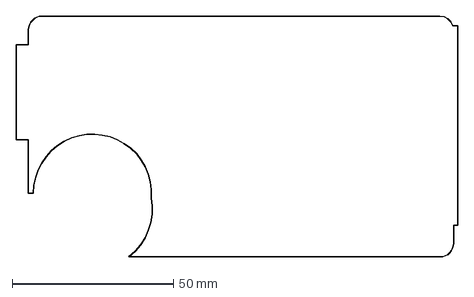
[picture p88: CAD file, 2026-10-21]
pcb/ergogen/output/outlines/pcb_right.dxf
136.8 x 74.7 mm
