kyonccc/zisaku/case/stl/bottom_left.stl

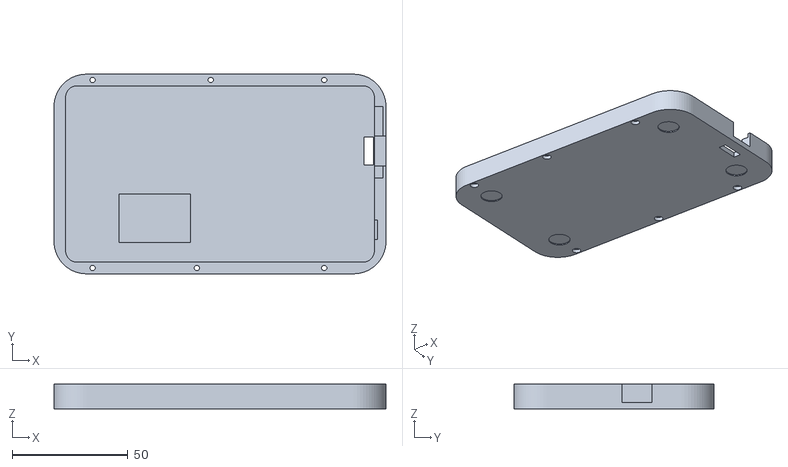
[picture p89: CAD file, 2026-10-17]
case/stl/bottom_left.stl
143.3 x 86.2 x 10.6
