kyonccc/zisaku/case/stl/mock/mock_top_right.stl

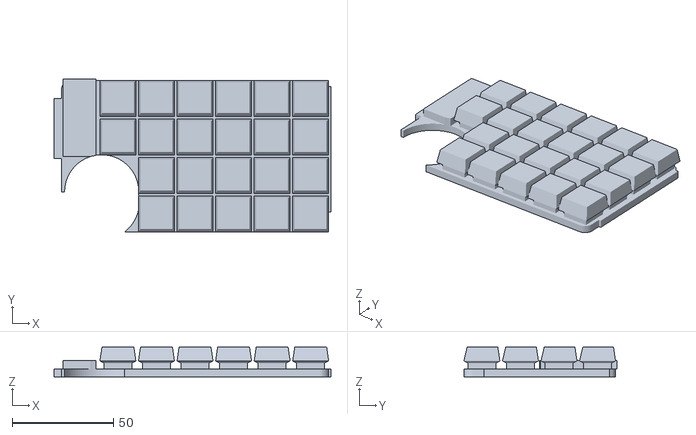
[picture p90: CAD file, 2026-10-21]
case/stl/mock/mock_top_right.stl
136.9 x 75.7 x 14.6
