kyonccc/zisaku/case/stl/mock_tilt/mock_ball_25_tilt15.stl

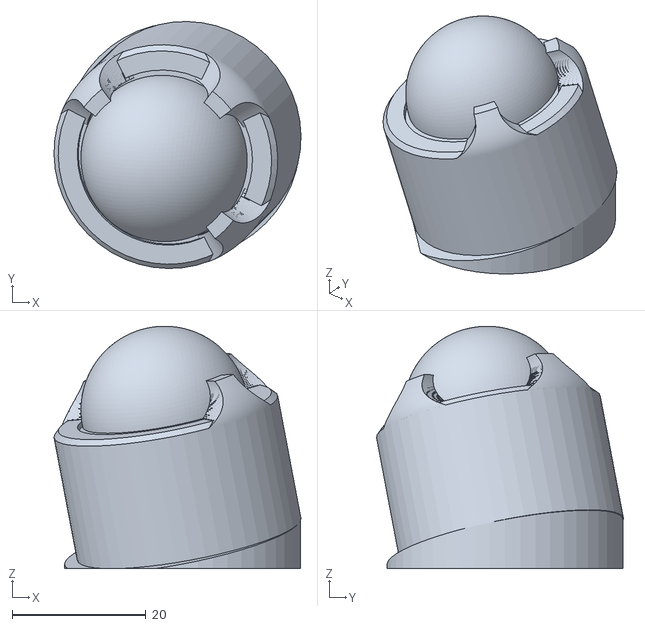
[picture p91: CAD file, 2026-10-20]
case/stl/mock_tilt/mock_ball_25_tilt15.stl
36.9 x 36.9 x 36.2
