kyonccc/zisaku/case/stl/ukishima/ball_deck.stl

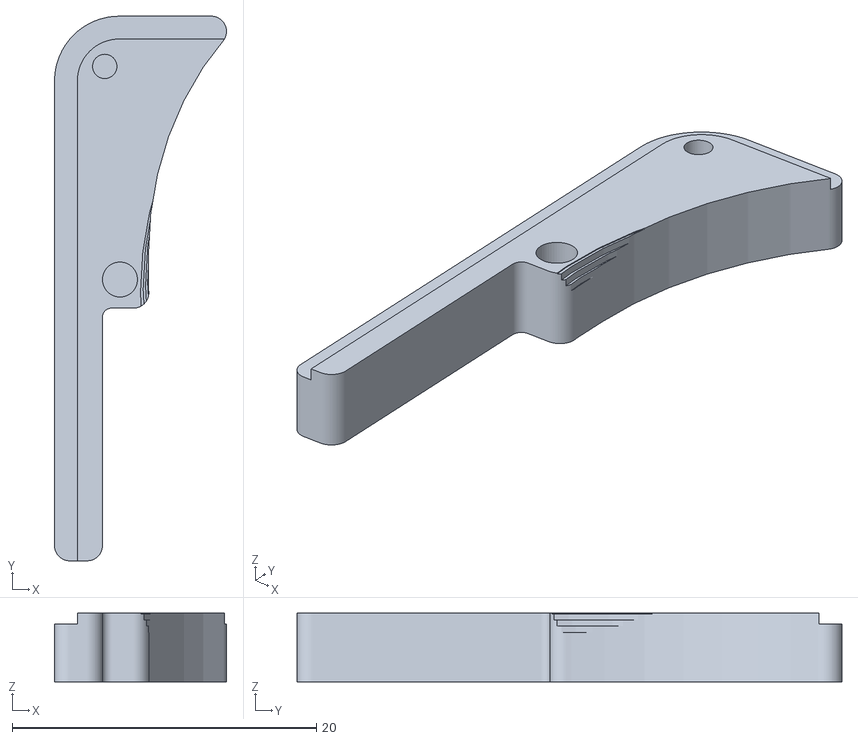
[picture p92: CAD file, 2026-10-21]
case/stl/ukishima/ball_deck.stl
11.3 x 35.8 x 4.50
