kyonccc/zisaku/pcb/ergogen/output/outlines/plate_right.dxf

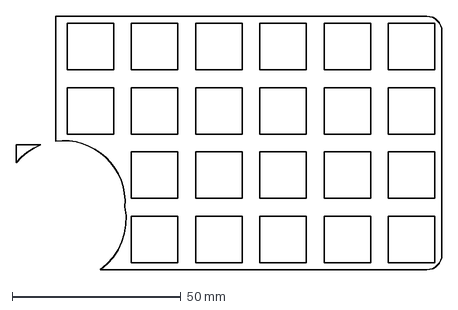
[picture p93: CAD file, 2026-10-21]
pcb/ergogen/output/outlines/plate_right.dxf
126.3 x 75.2 mm
