kyonccc/zisaku/case/stl/ball_base.stl

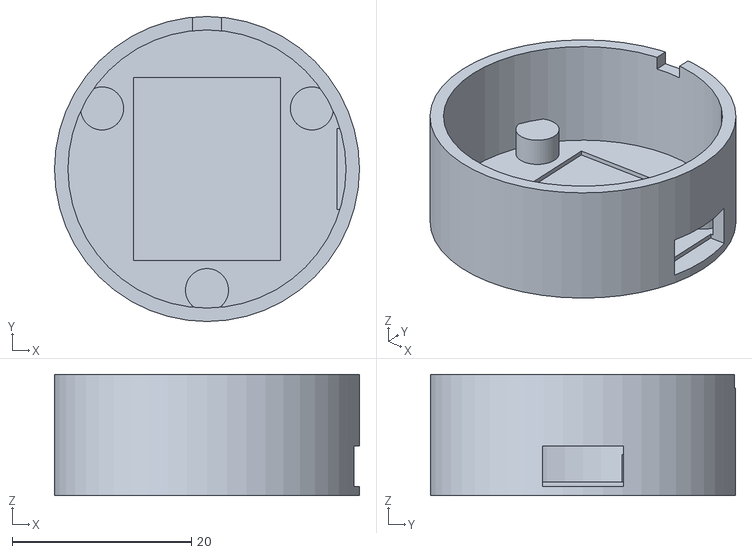
[picture p94: CAD file, 2026-10-17]
case/stl/ball_base.stl
34.0 x 34.0 x 13.5
