kyonccc/zisaku/case/stl/mock_worst/mock_top_right.stl

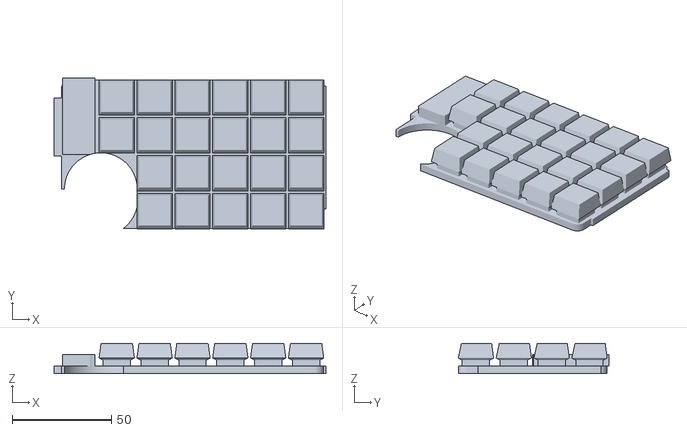
[picture p95: CAD file, 2026-10-21]
case/stl/mock_worst/mock_top_right.stl
136.9 x 75.7 x 15.2
