kyonccc/zisaku/case/stl/ukishima/tray_right.stl

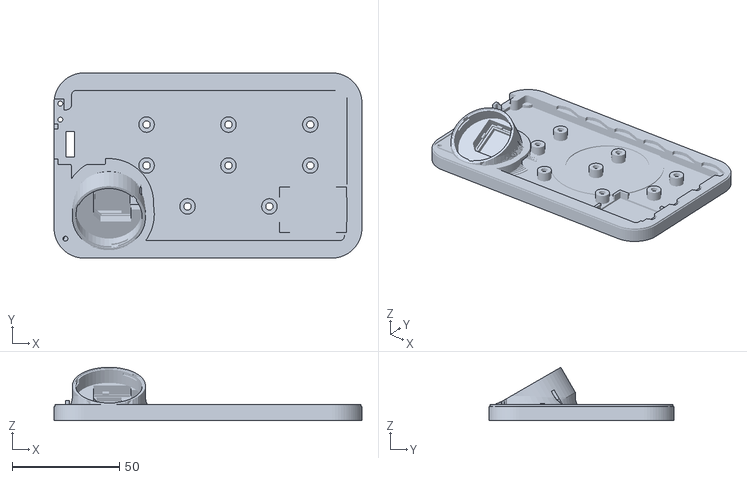
[picture p96: CAD file, 2026-10-21]
case/stl/ukishima/tray_right.stl
143.4 x 86.2 x 24.9
