kyonccc/zisaku/pcb/ergogen/output/outlines/ball_hole.dxf

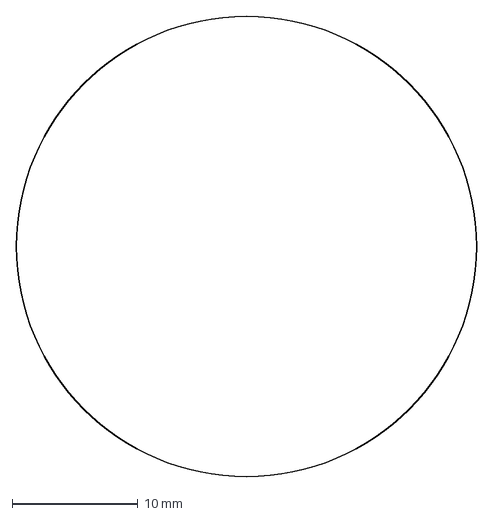
[picture p97: CAD file, 2026-10-21]
pcb/ergogen/output/outlines/ball_hole.dxf
36.6 x 36.6 mm
