kyonccc/zisaku/case/stl/ukishima/ball_cup_19.stl

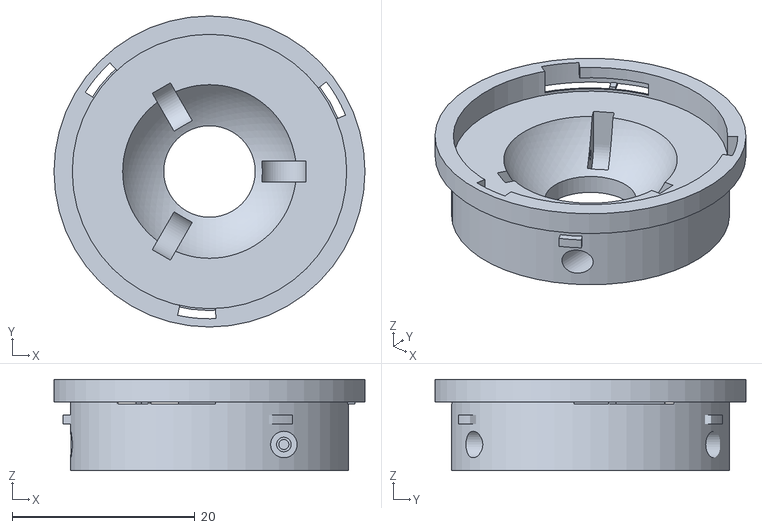
[picture p98: CAD file, 2026-10-21]
case/stl/ukishima/ball_cup_19.stl
34.0 x 34.0 x 10.0
