kyonccc/zisaku/pcb/ergogen/output/outlines/plate_left.dxf

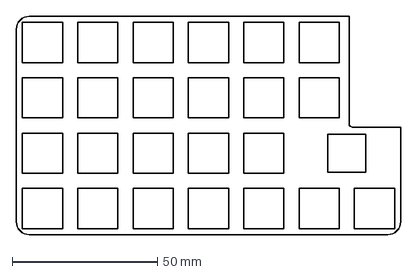
[picture p99: CAD file, 2026-10-19]
pcb/ergogen/output/outlines/plate_left.dxf
132.3 x 75.2 mm
