kyonccc/zisaku/case/stl/ball_cover_19.stl

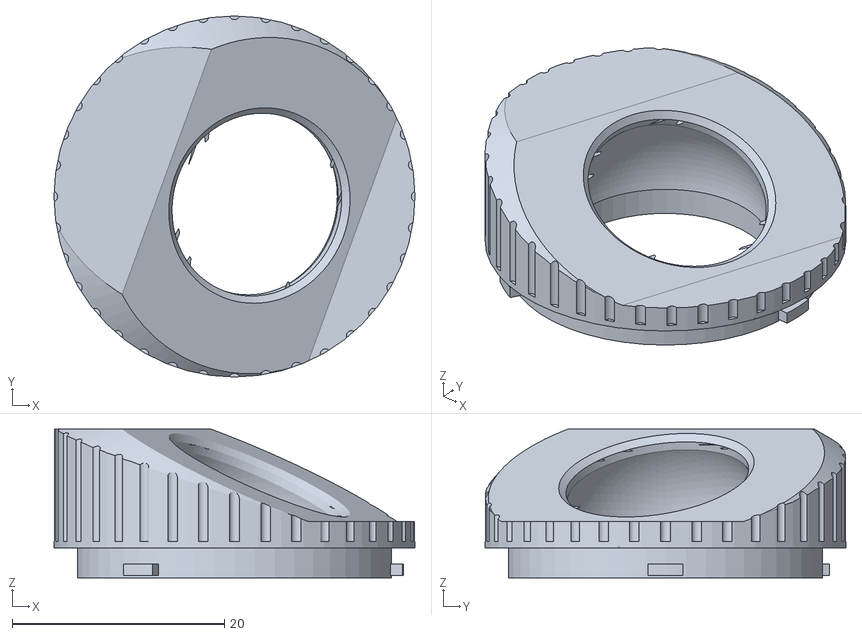
[picture p100: CAD file, 2026-10-16]
case/stl/ball_cover_19.stl
34.0 x 34.0 x 14.0
