kyonccc/zisaku/case/stl/mock/mock_tray_left.stl

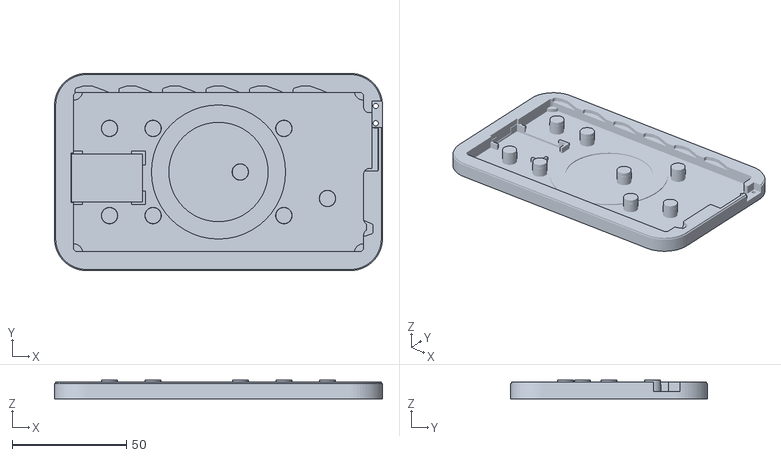
[picture p101: CAD file, 2026-10-21]
case/stl/mock/mock_tray_left.stl
143.4 x 86.2 x 8.15
