kyonccc/zisaku/case/stl/ukishima/ball_cup_25.stl

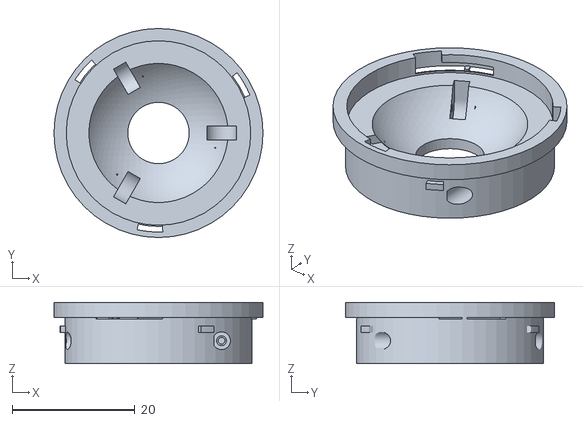
[picture p102: CAD file, 2026-10-21]
case/stl/ukishima/ball_cup_25.stl
34.0 x 34.0 x 10.0
