kyonccc/zisaku/pcb/ergogen/output/outlines/view_cut_right.dxf

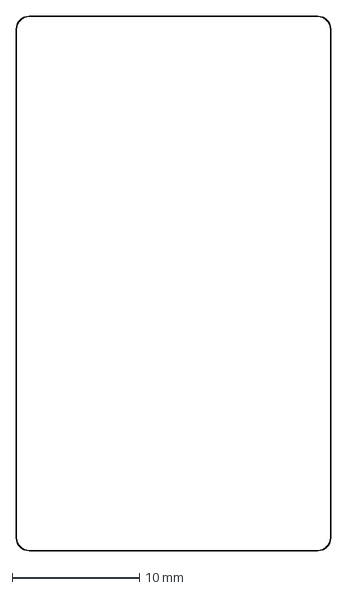
[picture p103: CAD file, 2026-10-19]
pcb/ergogen/output/outlines/view_cut_right.dxf
24.7 x 42.0 mm
