kyonccc/zisaku/case/stl/ball_cover_25.stl

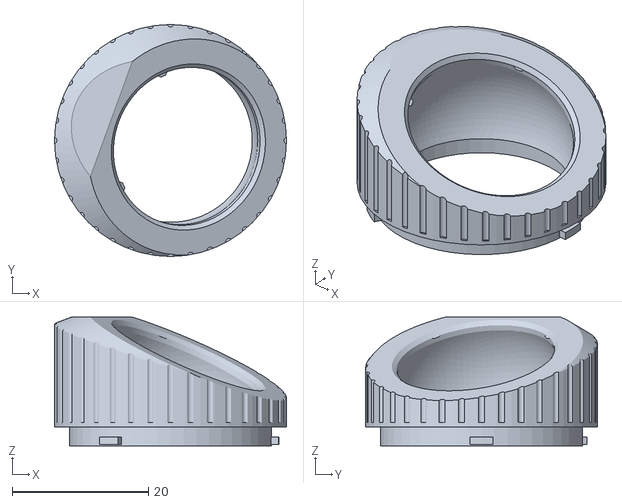
[picture p104: CAD file, 2026-10-16]
case/stl/ball_cover_25.stl
34.0 x 34.0 x 18.9
