kyonccc/zisaku/case/stl/mock/mock_top_left.stl

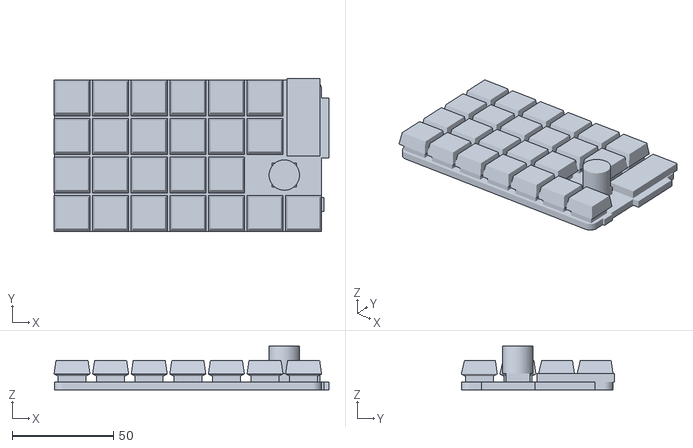
[picture p105: CAD file, 2026-10-19]
case/stl/mock/mock_top_left.stl
135.7 x 75.7 x 21.6
