kyonccc/zisaku/case/stl/mock_worst/mock_top_left.stl

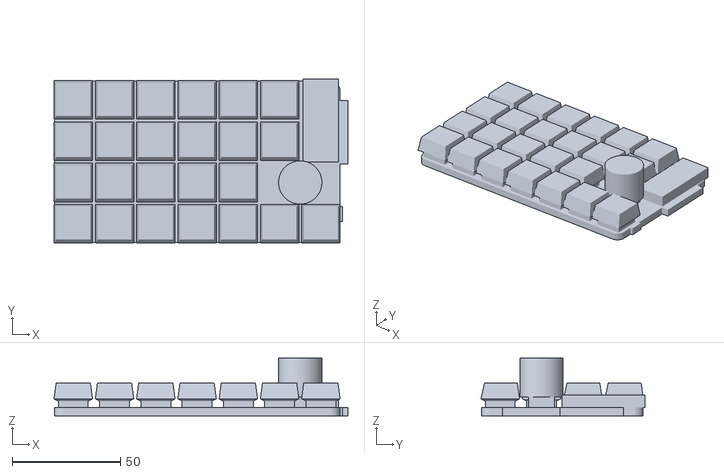
[picture p106: CAD file, 2026-10-19]
case/stl/mock_worst/mock_top_left.stl
135.7 x 75.7 x 26.6
