kyonccc/zisaku/case/stl/ukishima/tray_left.stl

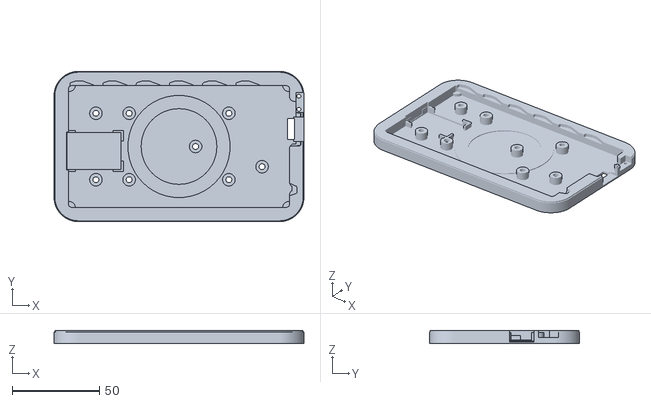
[picture p107: CAD file, 2026-10-21]
case/stl/ukishima/tray_left.stl
143.3 x 86.2 x 7.45
