kyonccc/zisaku/pcb/ergogen/output/outlines/view_cut_left.dxf

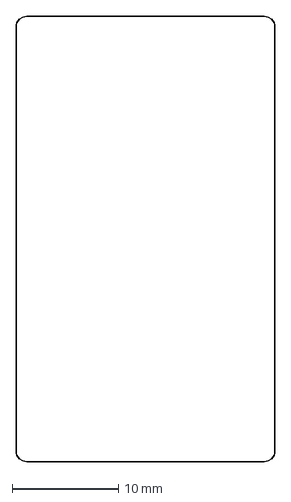
[picture p108: CAD file, 2026-10-19]
pcb/ergogen/output/outlines/view_cut_left.dxf
24.4 x 42.0 mm
