kyonccc/zisaku/case/stl/ukishima/view_cover_right.stl

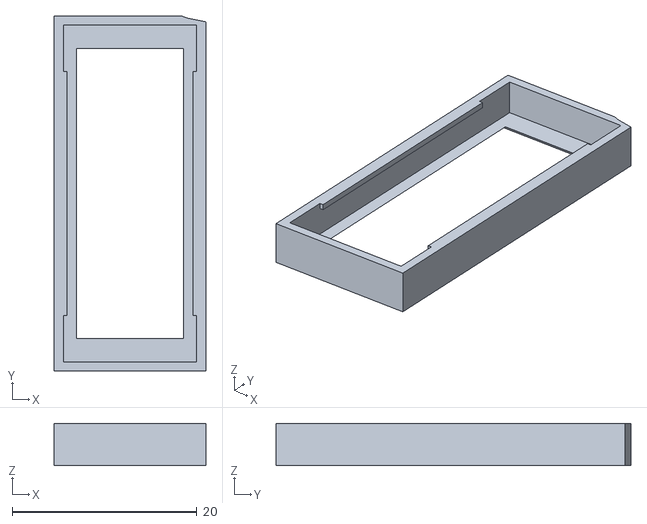
[picture p109: CAD file, 2026-10-19]
case/stl/ukishima/view_cover_right.stl
16.4 x 38.4 x 4.55
