kyonccc/zisaku/pcb/ergogen/output/outlines/plate_trim_right.dxf

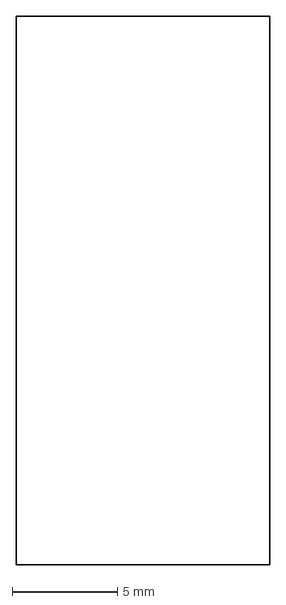
[picture p110: CAD file, 2026-10-19]
pcb/ergogen/output/outlines/plate_trim_right.dxf
12.0 x 26.0 mm
