kyonccc/zisaku/case/stl/ukishima/switch_cover_left.stl

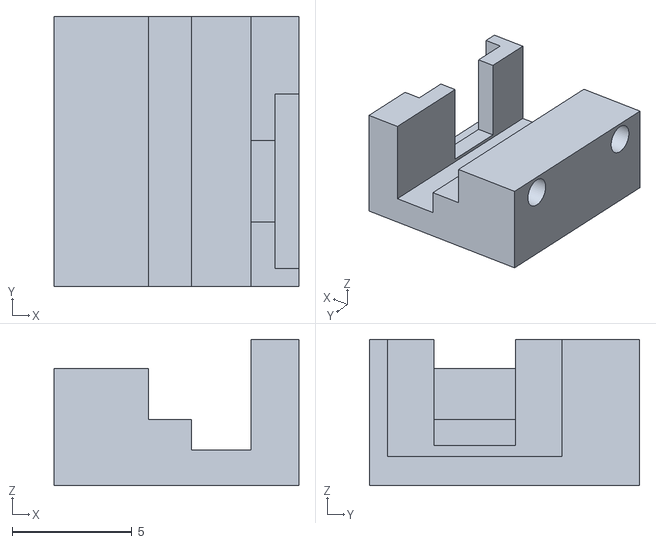
[picture p111: CAD file, 2026-10-19]
case/stl/ukishima/switch_cover_left.stl
10.2 x 11.3 x 6.12
