kyonccc/zisaku/pcb/ergogen/output/outlines/top_opening_right.dxf

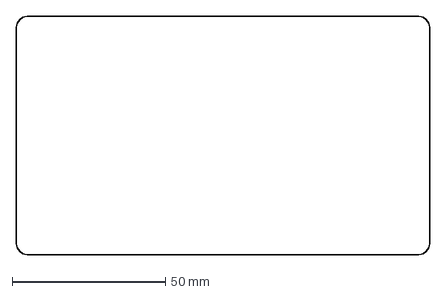
[picture p112: CAD file, 2026-10-17]
pcb/ergogen/output/outlines/top_opening_right.dxf
134.8 x 77.7 mm
