kyonccc/zisaku/pcb/ergogen/output/outlines/cavity_right.dxf

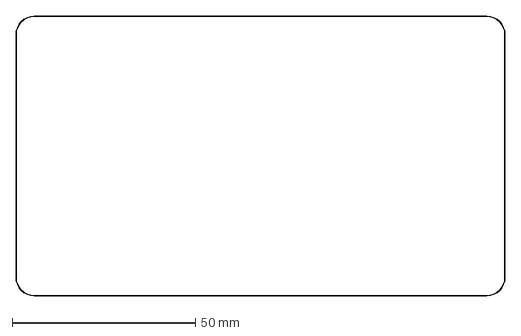
[picture p113: CAD file, 2026-10-17]
pcb/ergogen/output/outlines/cavity_right.dxf
133.3 x 76.2 mm
