kyonccc/zisaku/pcb/ergogen/output/outlines/pcb_left.dxf

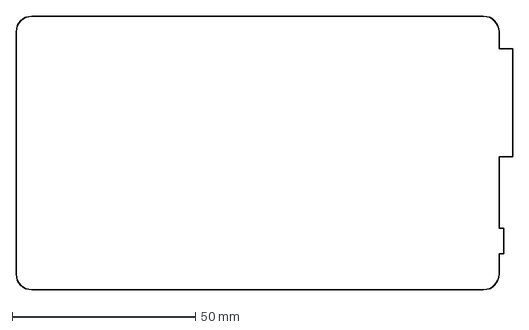
[picture p114: CAD file, 2026-10-16]
pcb/ergogen/output/outlines/pcb_left.dxf
135.6 x 74.7 mm
