kyonccc/zisaku/case/stl/ukishima/switch_slider.stl

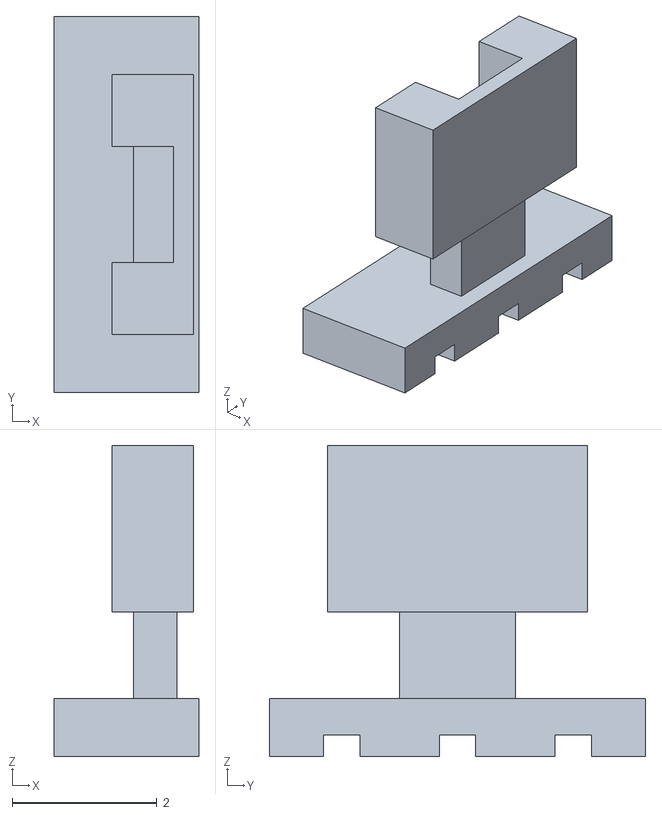
[picture p115: CAD file, 2026-10-19]
case/stl/ukishima/switch_slider.stl
2.00 x 5.20 x 4.30
