kyonccc/zisaku/pcb/ergogen/output/outlines/cavity_left.dxf

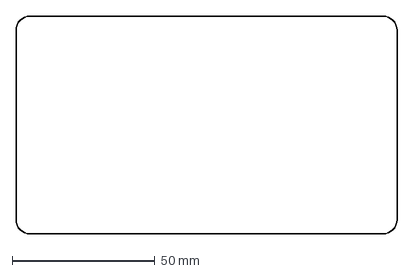
[picture p116: CAD file, 2026-10-16]
pcb/ergogen/output/outlines/cavity_left.dxf
133.3 x 76.2 mm
