kyonccc/zisaku/case/stl/ukishima/switch_knob.stl

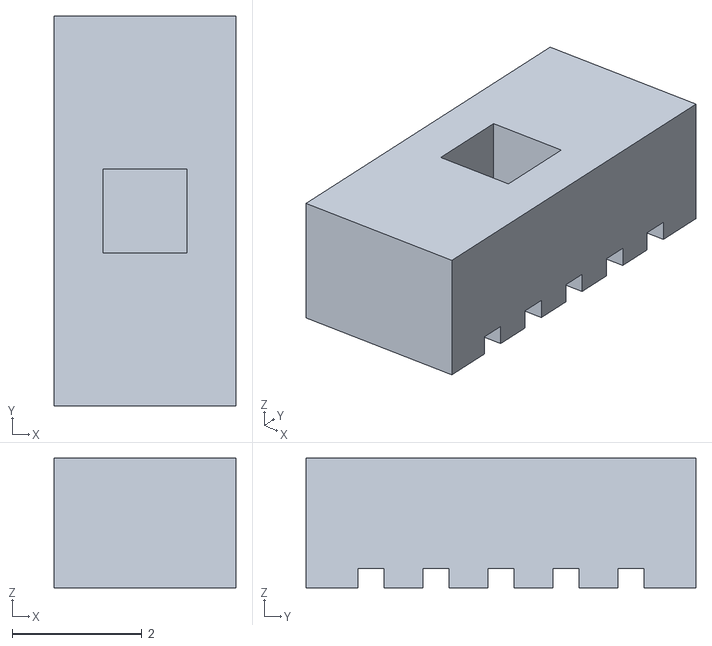
[picture p117: CAD file, 2026-10-19]
case/stl/ukishima/switch_knob.stl
2.80 x 6.00 x 2.00
