kyonccc/zisaku/pcb/ergogen/output/outlines/top_opening_left.dxf

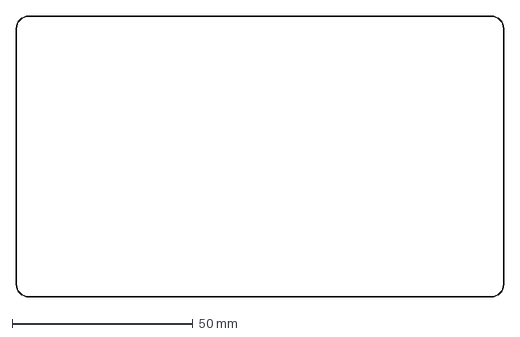
[picture p118: CAD file, 2026-10-16]
pcb/ergogen/output/outlines/top_opening_left.dxf
134.8 x 77.7 mm
