kyonccc/zisaku/pcb/ergogen/output/outlines/encoder_cut.dxf

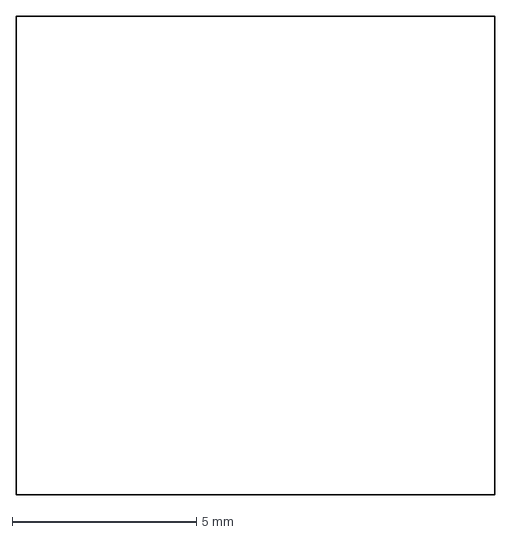
[picture p119: CAD file, 2026-10-15]
pcb/ergogen/output/outlines/encoder_cut.dxf
13.0 x 13.0 mm
