kyonccc/zisaku/pcb/ergogen/output/outlines/view_window_right.dxf

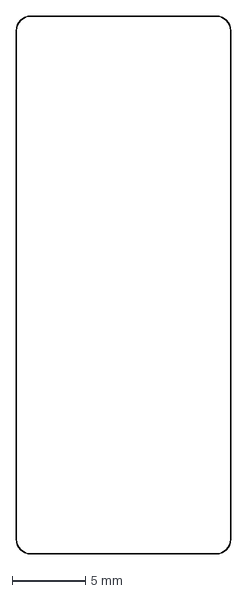
[picture p120: CAD file, 2026-10-15]
pcb/ergogen/output/outlines/view_window_right.dxf
14.6 x 36.6 mm
