kyonccc/zisaku/pcb/ergogen/output/outlines/keys_choc.dxf

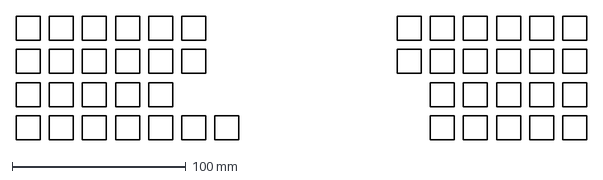
[picture p121: CAD file, 2026-10-15]
pcb/ergogen/output/outlines/keys_choc.dxf
328.1 x 71.0 mm
