kyonccc/zisaku/pcb/ergogen/output/outlines/view_window_left.dxf

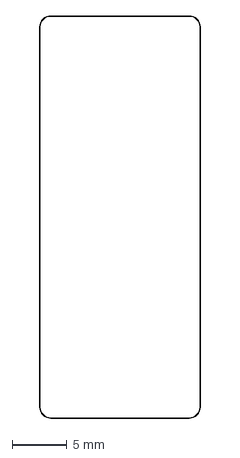
[picture p122: CAD file, 2026-10-15]
pcb/ergogen/output/outlines/view_window_left.dxf
14.6 x 36.6 mm
