kyonccc/zisaku/pcb/ergogen/output/outlines/board_right.dxf

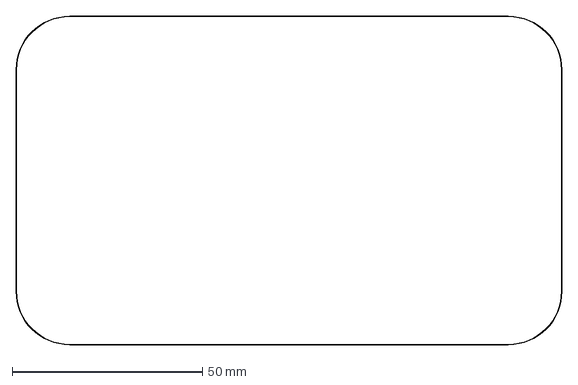
[picture p123: CAD file, 2026-10-15]
pcb/ergogen/output/outlines/board_right.dxf
143.3 x 86.2 mm
