kyonccc/zisaku/pcb/ergogen/output/outlines/board_left.dxf

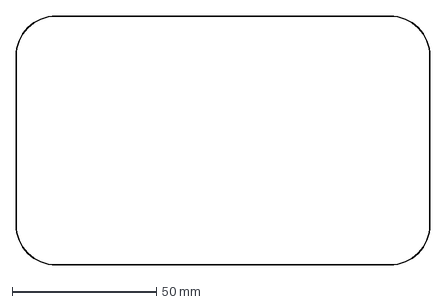
[picture p124: CAD file, 2026-10-15]
pcb/ergogen/output/outlines/board_left.dxf
143.3 x 86.2 mm
