kyonccc/zisaku/(list of files, cad)

Other CAD files:
case/stl/mock_worst/mock_tray_right.stl
case/stl/bottom_right.stl
case/stl/mock_worst/mock_deck.stl
case/stl/ukishima/switch_cover_right.stl
case/stl/ukishima/view_cover_left.stl
case/stl/old_gasket/bottom_right.stl
case/stl/old_gasket/top_left.stl
case/stl/old_gasket/top_right.stl
