kyonccc/zisaku/docs/template/kataware-template.pdf

# kataware 実寸テンプレート — 左手

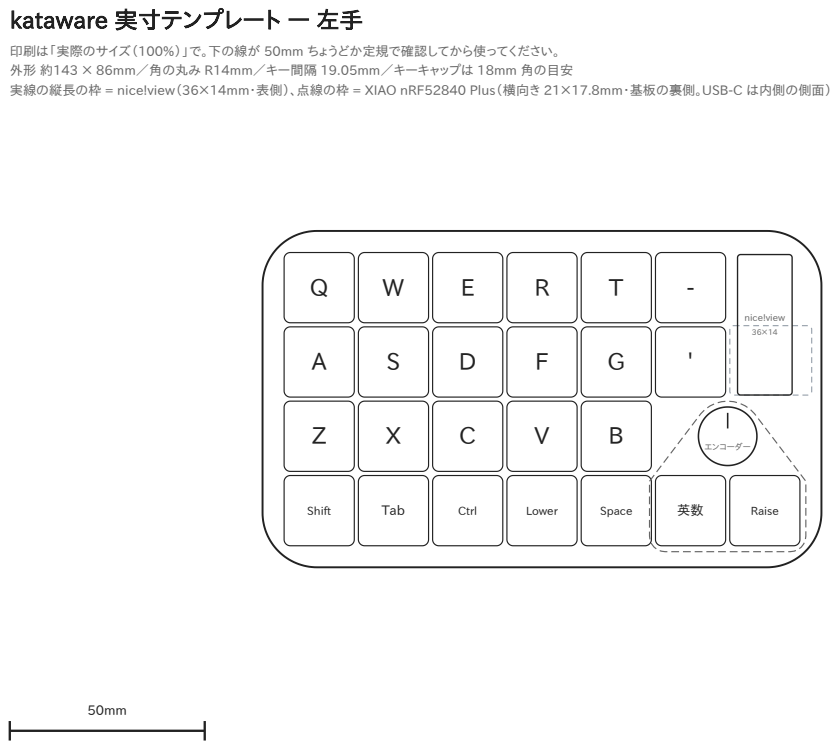
[picture p134: page 1]
Shift; Tab; Ctrl; Lower; Space; Raise; エンコーダー; nice!view

印刷は「実際のサイズ（100%）」で。下の線が 50mm ちょうどか定規で確認してから使ってください。
外形 約143 × 86mm／角の丸み R14mm／キー間隔 19.05mm／キーキャップは 18mm 角の目安
実線の縦長の枠 = nice!view（36×14mm・表側）、点線の枠 = XIAO nRF52840 Plus（横向き 21×17.8mm・基板の裏側。USB-C は内側の側面）

# kataware 実寸テンプレート — 右手

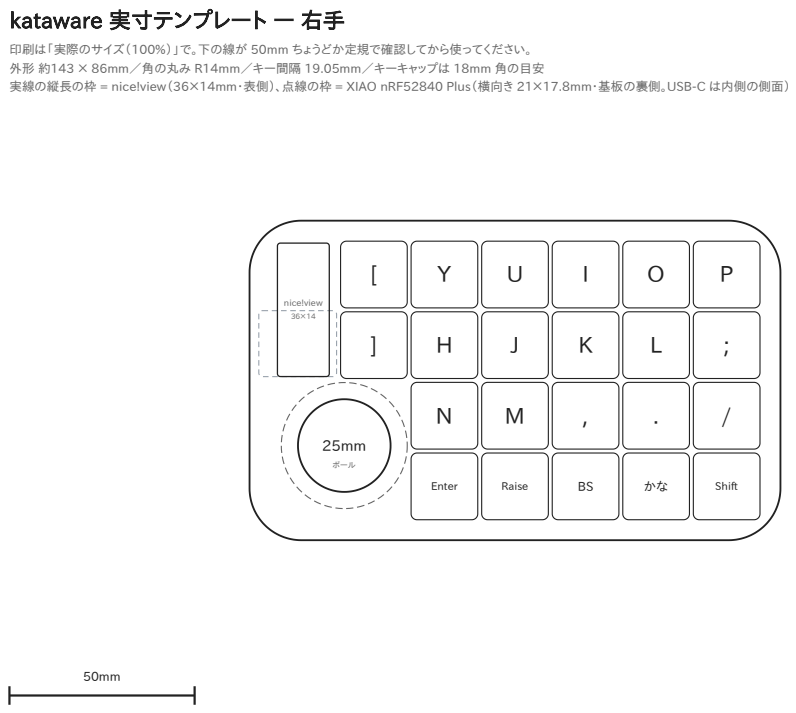
[picture p135: page 2]
Enter; Raise; Shift; ボール; nice!view

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
