kyonccc/zisaku/pcb/ergogen/output/pcbs/right.kicad_pcb

## KiCad design pcb/ergogen/output/pcbs/right.kicad_pcb (2026-10-21)

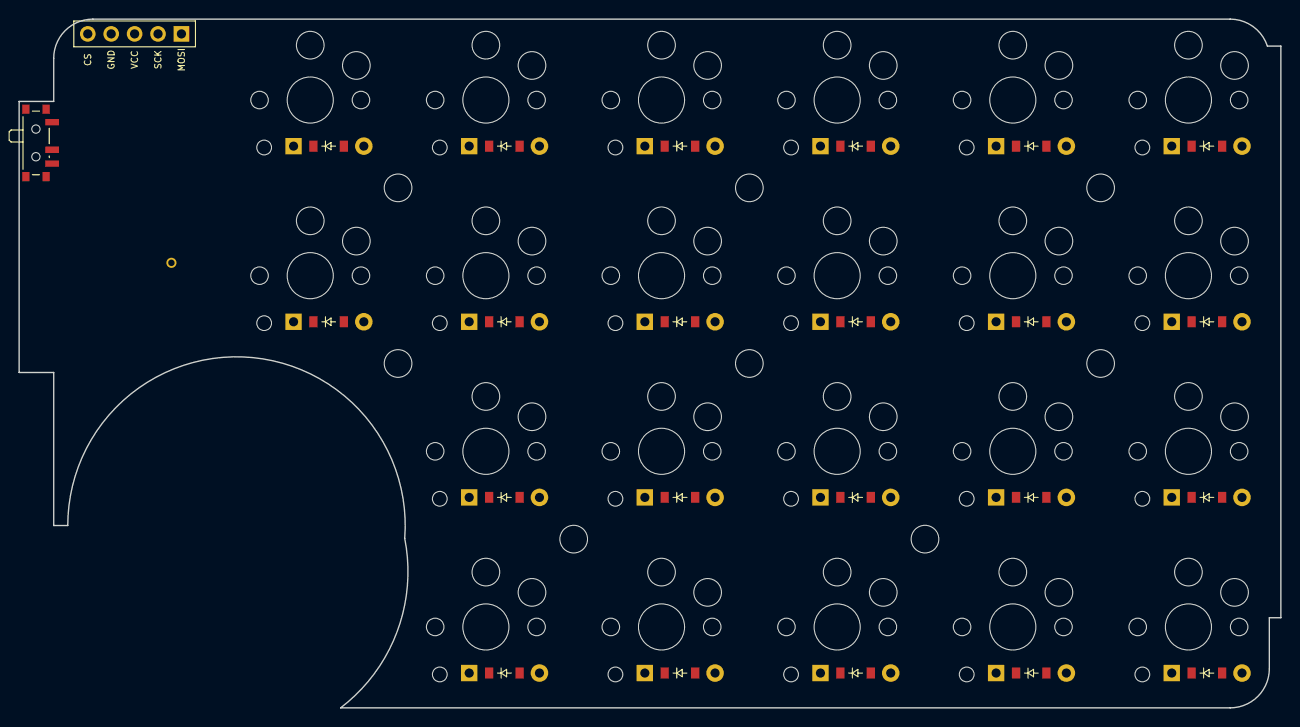
[picture p136: board right.kicad_pcb from above]

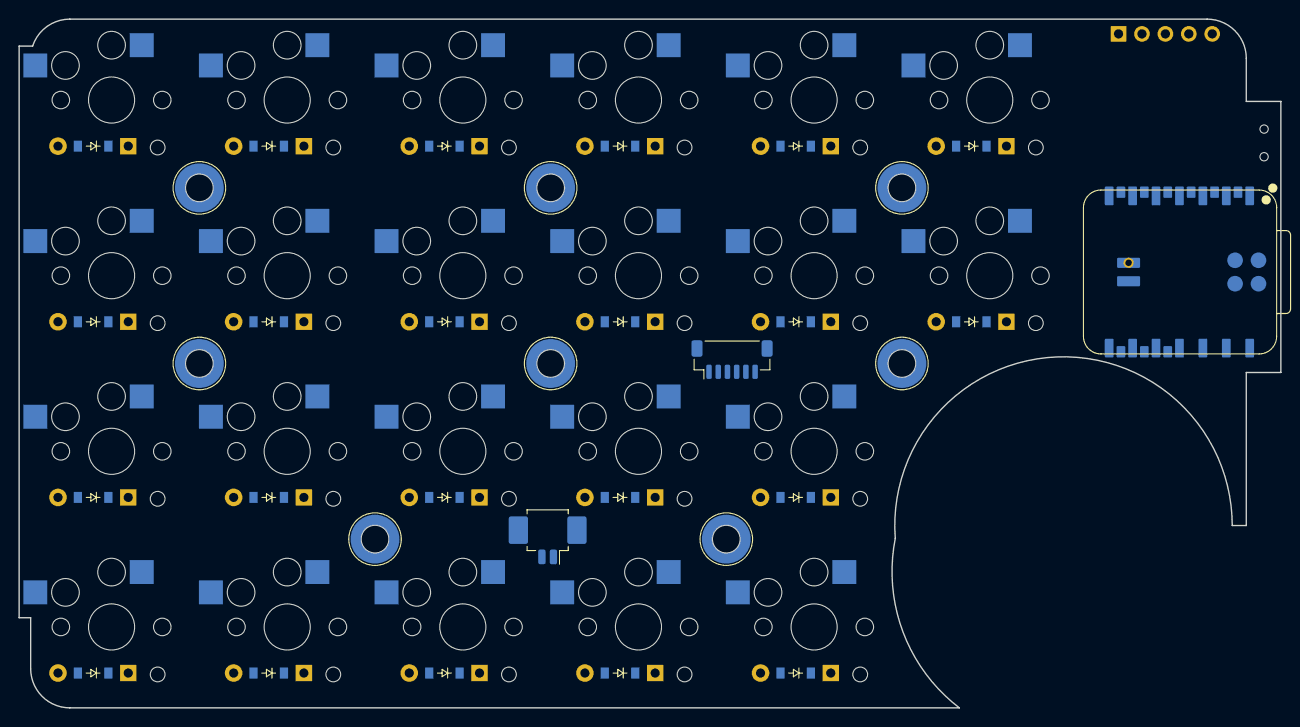
[picture p137: board right.kicad_pcb from below]

Board: 2 copper layers, 136.9 x 74.7 mm, 57 parts (11 on the bottom side), 43 nets, no tracks yet.

Parts:
BAT1: Molex_PicoBlade_53261-0271_1x02-1MP_P1.25mm_Horiz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; Molex_PicoBlade_53261-0271_1x02-1MP_P1.25mm_Horizontal
D1, D2, D3, D4, D5, D6, D7, D8, D9, D10, D11, D12, D13, D14, D15, D16, D17, D18, D19, D20, D21, D22: ComboDiode
DISP1: kataware_nice_view
H1, H2, H3, H4, H5, H6, H7, H8: SMT_Nut_M2
J1: JST_SH_BM06B-SRSS-TB_1x06-1MP_P1.00mm_Vertical
MCU1: XIAO-nRF52840-Plus-SMD
PWR1: SW_SPDT_PCM12
S1, S2, S3, S4, S5, S6, S7, S8, S9, S10, S11, S12, S13, S14, S15, S16, S17, S18, S19, S20, S21, S22: kataware_choc_v2_hotswap

Connections:
3V3: DISP1.3, J1.1, MCU1.12
BAT_P: BAT1.2, PWR1.1
BAT_SW: MCU1.28, PWR1.2
COL7: MCU1.5, S1.1, S2.1
COL8: MCU1.6, S3.1, S4.1, S5.1, S6.1
COL9: MCU1.7, S7.1, S8.1, S9.1, S10.1
COL10: MCU1.8, S11.1, S12.1, S13.1, S14.1
COL11: MCU1.9, S15.1, S16.1, S17.1, S18.1
COL12: MCU1.10, S19.1, S20.1, S21.1, S22.1
GND: BAT1.1, DISP1.4, J1.2, MCU1.13, MCU1.27, MCU1.29
ROW0: D2.1, D6.1, D10.1, D14.1, D18.1, D22.1, MCU1.1
ROW1: D1.1, D5.1, D9.1, D13.1, D17.1, D21.1, MCU1.2
ROW2: D4.1, D8.1, D12.1, D16.1, D20.1, MCU1.3
ROW3: D3.1, D7.1, D11.1, D15.1, D19.1, MCU1.4
TB_MOTION: J1.6, MCU1.16
TB_NCS: J1.5, MCU1.15
TB_SCLK: J1.3, MCU1.11
TB_SDIO: J1.4, MCU1.17
VIEW_CS: DISP1.5, MCU1.22
VIEW_MOSI: DISP1.1, MCU1.21
VIEW_SCK: DISP1.2, MCU1.23
right_c8_bottom: D4.2, S4.2
right_c8_home: D5.2, S5.2
right_c8_thumb: D3.2, S3.2
right_c8_top: D6.2, S6.2
right_c9_bottom: D8.2, S8.2
right_c9_home: D9.2, S9.2
right_c9_thumb: D7.2, S7.2
right_c9_top: D10.2, S10.2
right_c10_bottom: D12.2, S12.2
right_c10_home: D13.2, S13.2
right_c10_thumb: D11.2, S11.2
right_c10_top: D14.2, S14.2
right_c11_bottom: D16.2, S16.2
right_c11_home: D17.2, S17.2
right_c11_thumb: D15.2, S15.2
right_c11_top: D18.2, S18.2
right_c12_bottom: D20.2, S20.2
right_c12_home: D21.2, S21.2
right_c12_thumb: D19.2, S19.2
right_c12_top: D22.2, S22.2
right_e_home: D1.2, S1.2
right_e_top: D2.2, S2.2
