kyonccc/zisaku/(commit log)

2026-10-14 Initial commit: ZMK config for mykb split wireless trackball keyboard
    Claude-Session: https://claude.ai/code/session_017zNm7dMSTHELcztuNr6aNy
2026-10-14 Use nice_nano//zmk board variant required by ZMK on Zephyr 4.1
    The CI build failed because ZMK now requires the zmk board variant.
    Also update the firmware file names in the README to match.
    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
2026-10-14 README: add LiPo battery selection guide
    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
2026-10-14 Switch to 4x6 ortho layout with trackball on either half
    - Matrix is now a full 4x6 per side (48 positions); the four keys under
    the ball are simply unused on the trackball half (44 keys in use).
    - Move the PMW3610 setup into a kataware_trackball add-on shield. The
    half built with it becomes the central, so the ball can go on either
    side and the choice is made at flash time.
    - Build all four left/right x with/without trackball firmwares.
    - Update keymap, physical layout and README to match.
    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
2026-10-14 Add layout concept images for the 5-column trackball plans
    tools/draw_layout.py draws the images to scale (19.05mm pitch, 25mm ball).
    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
2026-10-14 Add trackball case concept diagrams (bearing type, sensor on bottom)
    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
2026-10-14 Adopt FrostOrtho-style 41-key layout with the trackball fixed on the right
    - Left: 5x4 ortho plus one extra key at the inner end of row 4 (21 keys).
    - Right: 5x4 ortho with a 25mm trackball strip on the inner side (20 keys).
    - Build only the left and right+trackball firmwares.
    - Add the final layout image and update the README (spec, wiring,
    keymap, bearing-type ball case with the sensor on the bottom).
    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
2026-10-14 Add left rotary encoder and make both cases the same size
    - EC11 encoder on the left half (A=D0, B=D1, push switch at ROW2/COL5).
    Turning controls volume (page up/down on Lower, brightness on Raise),
    pressing mutes.
    - Both halves now share the same outer size and corner radius; the left
    inner strip holds the controller, encoder and the extra key.
    - Update layout image and README, including the design policy.
    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
2026-10-14 Add a second inner thumb key (Raise) on the left half
    - Left half gets ROW3 x COL6 (D2) as an extra thumb key, assigned to
    Raise so the left hand can reach the Raise layer on its own.
    - Inner strips are now exactly two keys wide (38.1mm) on both halves,
    keeping the cases the same size (about 133 x 76mm).
    - Right half moves to columns 7-11 in the matrix transform.
    - Update layout image and README.
    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
2026-10-14 Add inner column keys next to T/G and Y/H (46 keys)
    - Left: COL5 x ROW0/ROW1 beside T and G.
    - Right: new innermost column on D21 for the keys beside Y and H.
    - Controllers move to the outer half of each inner strip; the ball
    and encoder positions are unchanged.
    - Default bindings: - and ' on the left, [ and ] on the right.
    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
2026-10-15 Group the left encoder, 英数 and Raise into a triangular cluster
    The encoder now sits centered above the two inner thumb keys so the
    three form one triangular cluster that mirrors the right-hand trackball.
    Only the physical position changes; the wiring stays the same.
    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
2026-10-15 Round the case corners (R14mm) and add a 1:1 printable template
    - Case outline: 5mm wall, R14mm corners (the largest that clears the
    corner keycaps); the left cluster frame gets rounded corners too.
    - tools/make_template.py builds an A4 landscape, 1:1 template (one page
    per half) with a 50mm scale check; the PDF is in docs/template/.
    - README: template usage and updated outer size.
    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
2026-10-15 Switch controller to XIAO nRF52840 Plus and add nice!view, power switch, reset
    - Use Seeed XIAO nRF52840 Plus (Japan radio certified) on both halves.
    All pins remapped to D0-D13 and D17-D19; D14/D15 (NFC) and D16 (VBAT)
    are left unused. The board's default I2C/SPI are disabled so their
    pins can be used for the key matrix.
    - Trackball moves to SCK=D10, SDIO=D13, CS=D11, MOTION=D12 on spi2.
    - nice!view on both halves via spi3 (SCK=D19, MOSI=D17, CS=D18).
    - Raise + inner extra key enters the bootloader (per half); a reset
    stick through the case handles recovery.
    - README: certification notes, pin tables, power slide switch wiring.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
2026-10-15 Add controller area layout (XIAO under the PCB, nice!view on top)
    - XIAO on the back of the PCB with nice!view stacked on the front in
    the same spot; USB-C at the rear edge, power slide switch on the
    inner side wall, reset pressed through a hole in the bottom plate.
    - tools/draw_controller.py draws the top view and cross-section.
    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
2026-10-15 Use measured XIAO Plus and nice!view dimensions
    - XIAO nRF52840 Plus: 21 x 17.8mm, about 5mm thick.
    - nice!view: 36 x 14 x 2.9mm; fits vertically in the 19.05 x 38.1mm
    controller area with about 1mm to spare at each end.
    - Leave at least 5.5mm under the PCB for the XIAO and battery.
    - Update diagrams, the 1:1 template and README.
    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
2026-10-15 README: specify MSK12C02 horizontal slide switch for power
    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
2026-10-15 README: decide on separate (non-reversible) left and right PCBs
    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
2026-10-15 Add Ergogen board and plate drafts
    - pcb/ergogen/config.yaml: key positions, 143.35 x 86.2mm R14 outlines,
    ball hole, encoder and nice!view windows, and part placement for the
    left and right halves.
    - MX and Choc hot-swap sockets overlap (holes ~2.7mm apart, MX pad cut
    by a Choc hole), so separate Choc and MX PCBs are generated.
    - Placeholder footprints for XIAO nRF52840 Plus and nice!view, and a
    6-pin header for the PMW3610 cable; routing is left for KiCad.
    - Generated KiCad PCBs and DXF outlines, images and README section.
    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
    [ball_hole.dxf, board_left.dxf, board_right.dxf, encoder_cut.dxf, keys_choc.dxf, keys_mx.dxf, left_choc.kicad_pcb, left_mx.kicad_pcb]
2026-10-15 Go Choc-only, add KiCad guide and case feel notes
    - Drop the MX variant: one PCB per half with a Choc v1/v2 hot-swap
    footprint (center hole widened to 5.05mm for Choc v2).
    - Ergogen outputs renamed to left/right PCBs and plate_left/right.
    - docs/kicad-guide.md: beginner steps for finishing the PCB in KiCad.
    - README: case ideas to keep a good typing feel (gasket mount,
    swappable plate materials, foam, flex cuts, weight).
    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
    [keys_mx.dxf, left.kicad_pcb, left_choc.kicad_pcb, plate_left.dxf, plate_mx_left.dxf, plate_mx_right.dxf, plate_right.dxf, right.kicad_pcb]
2026-10-15 Use Choc v2 and ceoloide footprints for switches and peripherals
    - Switches: ceoloide switch_choc_v1_v2 with v2 only (5.0mm center hole),
    hot-swap sockets on the back.
    - nice!view, EC11 encoder, side power switch (Alps SSSS811101) and
    JST PH battery connector now use ceoloide footprints; nice!view is
    rotated so its pins face the XIAO and USB-C.
    - Vendored footprints keep their licenses; README notes that the
    CC-BY-NC-SA parts block selling boards built from them.
    - Only the XIAO nRF52840 Plus remains a placeholder.
    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
    [left.kicad_pcb, right.kicad_pcb]
2026-10-15 Replace non-commercial footprints with own ones so the PCB can be sold
    - New kataware footprints: Choc v2 hot-swap (derived from Ergogen's MIT
    choc footprint, 5.0mm center hole, corner leg hole), nice!view (5 pins
    + outline), power switch placeholder (swap to KiCad SW_SPDT_PCM12) and
    an XIAO nRF52840 Plus placeholder carrying every pin's net per the
    firmware pin map.
    - Keep only MIT ceoloide footprints (encoder, JST PH); drop the
    CC-BY-NC-SA ones.
    - README and KiCad guide: license table and placeholder replacement.
    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
    [left.kicad_pcb, right.kicad_pcb]
2026-10-15 README: support swapping between 25mm and 19mm trackballs
    The PCB hole, 6-pin sensor header and firmware are shared; each ball
    size gets its own ball case unit. 34mm is out of scope.
    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
2026-10-15 README: pick PSE-certified Gexa batteries (GA-011 left, GA-012 right)
    Both use a 1.25mm-pitch connector, so the PCB connector will change
    from JST PH 2.0 once the actual connector type is confirmed.
    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
2026-10-15 README: use Gexa GA-011 (250mAh) on both halves for lighter weight
    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
2026-10-15 Use a 1.25mm battery connector placeholder for the Gexa GA-011
    The Gexa battery has a white 2-pin 1.25mm connector with no latch
    (likely Molex PicoBlade compatible); viewed from the terminal face,
    left is black (-) and right is red (+). The placeholder has pad 1 = GND
    and pad 2 = BAT_P and is to be swapped for KiCad's PicoBlade footprint,
    with polarity checked against the real battery.
    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
    [left.kicad_pcb, right.kicad_pcb]
2026-10-15 Add PCB overview image and bottom-screw ball unit mount; widen ball hole to 36mm
    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
    [ball_hole.dxf, pcb_right.dxf, plate_right.dxf, right.kicad_pcb]
2026-10-16 Gasket-mount PCB/plate outlines and 3D-printable case
    - Ergogen: cavity/top-opening outlines, plate with 6 gasket tabs,
    PCB 0.75mm inside the case with tongues for USB-C and power switch
    - XIAO turned sideways so USB-C exits the inner side wall
    - case/kataware_case.py builds top and bottom case STLs from the DXFs
    - Section drawings, 3D renders and README/KiCad guide updates
    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
    [ball_bulge.dxf, ball_cut.dxf, bottom_left.stl, bottom_right.stl, cavity_left.dxf, cavity_right.dxf, left.kicad_pcb, pcb_left.dxf]
2026-10-16 Add trackball unit: fixed base with sensor and swappable 25/19mm cups
    - case/ball_unit.py builds the base (screwed from below, sensor pocket,
    cable exit, orientation notch) and cups with three MR63ZZ bearings
    - Both cups keep the ball bottom at the same height so the sensor gap
    stays 2.4mm; swapping is lift-out, no screws
    - Base screws moved to 30/150/270 deg to leave the cable exit free
    - Section drawn from the real model; old concept drawings removed
    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
    [ball_base.stl, ball_cup_19.stl, ball_cup_25.stl, bottom_right.stl]
2026-10-16 Thumb-oriented ball cover: tilted, magnet-held, ball-only removal
    - New 25mm/19mm covers tilt 25 deg toward the thumb (Enter side); the
    thumb-side rim sits at keycap height, the far side forms a backstop
    - Rim opening is 0.8mm smaller than the ball so it does not fall out;
    three 3x2mm magnets hold the cover, a pin keys its orientation
    - Cups now end below the ball centre so the ball lifts out once the
    cover is off; bearings can be lifted out for cleaning
    - Thumb-direction section drawing and README notes on the angle
    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
    [ball_cover_19.stl, ball_cover_25.stl, ball_cup_19.stl, ball_cup_25.stl]
2026-10-16 Ball unit: use 681X (4mm) bearings on 1.5mm pins, after FrostOrtho
    Smaller bearings let both cups use a 45 deg contact and smaller slots.
    README credits the ideas taken from the FrostOrtho trackball case
    (ideas only; its data is personal-use licensed).
    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
    [ball_cup_19.stl, ball_cup_25.stl]
2026-10-16 Ball unit: M1.4 screw axles for adjustable bearing feel
    Bearings drop into the cup from above; an M1.4x6 tapping screw enters
    from the cup's outer wall, passes through the bearing and threads into
    a pilot hole. With 0.15mm side clearance, tightening lets the walls
    pinch the bearing, trading play for smoothness. Adds an axle section
    drawing, README adjustment steps and BOM change; section drawings now
    fill holes correctly and use higher-contrast colours.
    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
    [ball_cup_19.stl, ball_cup_25.stl]
2026-10-16 Ball cover: twist-lock bayonet instead of magnets
    The cover gets a spigot ring with three unevenly spaced lugs; the cup
    gets entry slots and grooves. Drop in, twist 30 deg clockwise past a
    small detent to lock, so a stray finger cannot pop it off; unequal lug
    spacing fixes the orientation so the low side faces the thumb. Grip
    flutes on the cover, a lock diagram, and README/BOM updates (magnets
    removed). The build now checks for cup/cover overlap when locked and
    when inserted.
    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
    [ball_cover_19.stl, ball_cover_25.stl, ball_cup_19.stl, ball_cup_25.stl]
2026-10-17 Move the trackball under the [ ] column at the N row
    - Ball centre to (-8, 11) from the e column / thumb row: the cover now
    ends ~1mm below the ] keycap and ~1mm from N/Enter (the limit)
    - The unit now sits inside the case cavity, so the right case wall
    bulge is gone and both halves share the same cavity
    - XIAO raised 1.5mm to clear the ball hole; sensor cable moves to a
    JST SH 6-pin SMD connector (J) on the back between Enter and N, and
    the base cable exit faces it
    - Fix draw_case_section so the thumb/tab/USB sections are written again
    - README, KiCad guide, template and images updated
    Claude-Session: https://claude.ai/code/se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
    [ball_base.stl, ball_bulge.dxf, ball_cut.dxf, ball_hole.dxf, bottom_left.stl, bottom_right.stl, cavity_right.dxf, left.kicad_pcb]
2026-10-18 Fix KiCad load error: unconnected pads emitted 'undefined' as net
    XIAO placeholder pad 14 (5V) has no net, and the footprint printed the
    JS value undefined into the .kicad_pcb, which KiCad rejects. All custom
    footprints now emit nothing for an empty net. Verified both boards load
    with kicad-cli.
    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
    [left.kicad_pcb, right.kicad_pcb]
2026-10-18 Power switch placeholder: match SW_SPDT_PCM12 pad layout and orientation
    The placeholder had its pads on the opposite side to KiCad's PCM12, so
    'Change Footprint' left the lever pointing into the board. Pads now
    match PCM12 (pins at -y, lever at +y) and the rotations point the lever
    out through the side wall on both halves.
    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
    [left.kicad_pcb, right.kicad_pcb]
2026-10-18 Use real footprints for XIAO Plus, power switch and connectors
    - tools/import_footprints.py converts .kicad_mod files (vendored in
    pcb/ergogen/lib_src) into Ergogen footprints with per-pad nets and
    back-side mirroring; KiCad library PCM12, JST SH BM06B and Molex
    PicoBlade, plus Seeed's official XIAO nRF52840 Plus (CC-BY-SA, credited)
    - XIAO pad 28 (VBAT) gets a 0.7mm through-hole so it can be soldered
    from the front, as it sits hidden under the module
    - Power switch moved 0.65mm inwards so its mounting pads stay on the
    board; battery connectors rotated to face the battery
    - Diodes moved 2mm right: their THT pad overlapped the switch's 1.6mm
    locating hole on every key
    - tools/chec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
    [left.kicad_pcb, right.kicad_pcb]
2026-10-18 Concept 'Ukishima': floating PCB around a trackball pillar (images only)
    Low tray with the PCB + thin plate held on poron-topped posts (6 outer,
    2 inner) so it floats above the rim; the ball unit is sunk into the
    floor as a standalone pillar; cover lowered (0.5mm lip, 20 deg tilt).
    case/concept_ukishima.py builds the visual model, tools/draw_concept.py
    the section; summary in docs/concept/README.md.
    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
2026-10-18 Concept Ukishima v2: lower stack and claw-set ball cover
    Floor 1.5mm, battery in a floor pocket and 5.85mm under the PCB bring
    key tops to ~19.1mm; the ball base floor drops to 1mm (ball top ~32.5mm).
    The cover becomes a low ring flush with the keycaps plus three slim
    claws following the ball (0.7mm overlap), leaving the thumb side open.
    Previous renders kept as ukishima-v1-*.
    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
2026-10-18 Concept: stronger FDM-friendly claws for the ball cover
    Claws are 2.4mm thick, 8mm wide at the root tapering to 4mm, with a
    45-degree buttress on the outside so they print support-free in PLA
    (e.g. Bambu A1 mini) and keep the 0.7mm overlap. Adds a claw section,
    cover render and print settings / strength estimate to the concept notes.
    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
2026-10-18 Concept: claws blend into the ring with a curved profile
    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
2026-10-19 Concept: place claws away from typing fingers, add burger-mount screws
    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
2026-10-19 Concept: add 34mm ball variant and size comparison images
    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
2026-10-19 Concept: fix the PCB from below with SMT nuts so no screws show on top
    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
2026-10-19 Concept: dedicated 34mm ball unit with fixed claw and outer twist-lock hood
    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
2026-10-19 Concept: update open items for 34mm
    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
2026-10-19 Concept: MagSafe ring groove for tenting, tilt-safe bearing layout
    - Groove for a MagSafe magnet ring under each tray; battery and posts moved around it
    - Bearings at 0/120/240 deg (one on the downhill side when tented): stays seated up to ~45 deg
    - 34mm unit supports the ball at 45 deg like 25/19mm
    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
    [ball_cup_19.stl, ball_cup_25.stl]
2026-10-19 README: note tilt-safe bearing layout
    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
2026-10-19 Concept: groove sized for a 0.4-0.6mm MagSafe metal ring
    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
2026-10-19 Ukishima: production data (tray, ball units, PCB nuts, plates)
    - case/ukishima.py builds printable STLs into case/stl/ukishima/ and checks fit
    - PCB: M2 SMT nuts at the 8 post positions; battery connectors moved beside
    the relocated batteries; encoder diode shifted off a post
    - Plates lose the gasket tabs; nice!view corner cut so no thin slivers remain
    - check_pcb.py also checks back-side part overlap and parts above the battery
    - docs/ukishima-build.md: BOM, printing and assembly; gasket case kept as old version
    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
    [ball_base.stl, ball_base_34.stl, ball_cover_19.stl, ball_cover_25.stl, ball_cup_19.stl, ball_cup_25.stl, ball_hood_34.stl, bottom_left.stl]
2026-10-19 Ukishima: battery guides, power switch cover with slider, nice!view cover
    - Tray: L-shaped guides at the battery pocket corners; pocket in the wall for the switch cover
    - Switch cover screwed from below; slider fork moves the PCM12 lever and tolerates PCB float
    - Snap-on nice!view cover with window; plate corner cut enlarged so the cover fits
    - ukishima.py checks the new parts (PCB float, both lever positions, plate, ball unit)
    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
    [plate_left.dxf, plate_right.dxf, switch_cover_left.stl, switch_cover_right.stl, switch_slider.stl, tray_left.stl, tray_right.stl, view_cover_left.stl]
2026-10-19 Ukishima: power switch knob sticks out sideways; fix switch cover assembly order
    - Slider (fork + stem) passes through a slot in the cover's outer wall; separate knob presses on
    - Roof is now solid; cover slides in from the side after the PCB is fixed (checked in ukishima.py)
    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
    [switch_cover_left.stl, switch_cover_right.stl, switch_knob.stl, switch_slider.stl]
2026-10-19 Ukishima: back to a top slide knob, sunk into a recess in the cover roof
    The one-piece knob needs no glue; its top sits 0.1mm below the roof so it
    does not get pushed on in a bag. Cover still slides in from the side after the PCB.
    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
    [switch_cover_left.stl, switch_cover_right.stl, switch_slider.stl]
2026-10-19 Ukishima: corner magnets with rubber feet for carrying and desk use
    - Four neodymium magnets (6x2mm) under rubber feet at mirror-symmetric corners,
    so the halves stack back to back; polarity rule documented
    - Ball unit tabs moved to 70/150/300 deg to free the bottom-left corner
    - ukishima.py checks magnet clearance; overview and carry renders updated
    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
    [ball_base.stl, ball_base_34.stl, tray_left.stl, tray_right.stl]
2026-10-19 Ukishima: hide the batteries behind low screen walls; limit PCB travel to 0.4mm
    - Screen walls inside the PCB edge near each battery (lower under sockets, with a 2mm lip)
    - Batteries nudged away from the PCB edge so the walls fit
    - Poron set to 1.9mm so the PCB can sink at most 0.4mm: sockets above the battery
    no longer touch it at full travel (checked in ukishima.py)
    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
    [tray_left.stl, tray_right.stl]
2026-10-19 Check the hotswap sockets on the PCB underside; move connectors clear of them
    The socket footprints sit on the front layer, so the back-side checks skipped
    them. Now the socket bodies are modeled and checked against nuts, connectors,
    posts, poron, battery, screens, ball unit and switch cover (also at full PCB travel).
    - Battery connectors (left/right) and the sensor connector J1 moved into free spots
    - Tray rim trimmed under the outer-column sockets at the top-right corner
    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
    [left.kicad_pcb, right.kicad_pcb, tray_left.stl, tray_right.stl]
2026-10-19 Ukishima: full PCB parts list and height stack; fix clashes it revealed
    - check_pcb reads KiCad 8 footprints too (the encoder was skipped): the post
    under the encoder pins moved to a free spot under the encoder
    - All back-side parts (XIAO, connectors, SOD-123 diodes, nuts, trimmed pins,
    sockets) are modeled with heights and checked at full PCB travel
    - PCB raised 0.3mm so a thicker battery (+0.3) still clears the sockets
    - Tray wall recessed under the XIAO end; power switch moved 1mm back so its
    cover clears the XIAO
    - nice!view height from a standard 2.5mm pin header; switch cover heights follow the PCB
    - docs: parts table (incl. no resistors needed) and height stack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
    [ball_base_34.stl, ball_cover_19.stl, ball_cover_25.stl, ball_hood_34.stl, left.kicad_pcb, right.kicad_pcb, switch_cover_left.stl, switch_cover_right.stl]
2026-10-19 Add a full parts list with height fields, and a size/height mock to print
    - docs/parts-list.md: every part for one keyboard with the dimensions the design
    assumes, a column for measured values and the constant to change
    - case/mock.py: tray, top block (PCB + plate + keys + nice!view + encoder) and
    ball unit envelopes from the same height constants
    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
    [mock_ball_19.stl, mock_ball_25.stl, mock_ball_34.stl, mock_top_left.stl, mock_top_right.stl, mock_tray_left.stl, mock_tray_right.stl]
2026-10-19 Read part dimensions from case/parts_dims.json; mock can use a worst-case profile
    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
2026-10-19 Mock STLs are placed on the A1 mini bed (centered, flat side down) and size-checked
    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
    [mock_top_left.stl, mock_top_right.stl, mock_tray_left.stl, mock_tray_right.stl]
2026-10-19 Add worst-case part dimensions and mock, Choc v2 part candidates
    - parts_dims.json: researched values (MX-stem low-profile keycaps, EC11 20mm shaft, nut OD 4.35)
    - parts_dims_worst.json + mock.py --worst -> case/stl/mock_worst (A1 mini size check)
    - SMT nut footprint: Wurth WA-SMSI M2 (NPTH 3.0, pad 5.3)
    - Ball ring top capped at 19.75 so claws stay valid with taller keycaps
    - docs: candidate tables (sockets, keycaps, nice!view, encoder, connectors, batteries), height stack
    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
    [ball_base_34.stl, ball_hood_34.stl, left.kicad_pcb, mock_ball_19.stl, mock_ball_25.stl, mock_ball_34.stl, mock_top_left.stl, mock_top_right.stl]
2026-10-20 Add ball tilt trial mocks (25mm at 0/15/30 deg, diagonal claws)
    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
    [mock_ball_25_tilt00.stl, mock_ball_25_tilt15.stl, mock_ball_25_tilt30.stl]
2026-10-20 Redesign trackball case: tilted lower case (20 deg, left-front), flat bottom screwed from tray, diagonal claws
    - 19/25mm: shared lower case tilted 20deg toward left-front and sunk until the sensor board corner sits 0.6mm above the bottom; flat bottom, wedge under the high side, 3 tabs screwed from the tray underside, cable down through the wedge and out a window above the floor
    - 34mm: own lower case, upright, same tab/screw positions
    - Claws moved to 45/135/315 (180deg opening toward the thumb)
    - PCB/plate ball cut enlarged on the left and front only (works for 15-30deg)
    - Tray hole follows the lower case footprint; mocks and checks updated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
    [ball_base.stl, ball_base_34.stl, ball_cover_19.stl, ball_cover_25.stl, ball_cut.dxf, ball_lower.stl, ball_lower_34.stl, left.kicad_pcb]
2026-10-21 Same 20deg tilt for 19/25/34, split 34mm lower case and cup, settle sensor board housing
    - 34mm now tilts 20deg like 19/25; lower34 + cup34 so the sensor board goes in from the top
    - Sensor board held in a 0.5mm pocket, pressed at 4 corners by cup legs; side-entry JST SH on the +x edge; cable down through the wedge to a window above the floor
    - Sensor dims and lens height come from parts_dims.json (worst: lens 4.0)
    - PCB/plate ball cut: r18.3 + r18.4 offset circle, clear for all sizes at 15-30deg
    - Checks for sensor fit, cup legs, floor thickness; cover/hood/ball vs tray
    Claude-Session: https://claude.ai/code/session_017zNm7dMSTHELcztu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
    [ball_cup_19.stl, ball_cup_25.stl, ball_cup_34.stl, ball_cut.dxf, ball_hole.dxf, ball_lower.stl, ball_lower_34.stl, mock_ball_19.stl]
2026-10-21 34mm: thumb operation, claws at 45/135/315 like 19/25, hood spans 130-320
    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
    [ball_hood_34.stl, mock_ball_34.stl]
2026-10-21 Integrate the ball socket (lower case) into the right tray
    - Common socket for 19/25/34mm (OD 35.4, bore 32.4), tilted 20deg, merged into tray_right; no screws/inserts
    - Sensor board snaps into the pocket with two clips and stays when cups are swapped
    - 19/25 cups widened to 31.8mm; 34mm cup carries the fixed claw and hood ledges
    - Checks: cups/covers/ball/sensor vs tray socket, clip engagement
    - Mocks: tray includes the socket, ball mocks are plug-in upper parts
    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
    [ball_cover_19.stl, ball_cover_25.stl, ball_cup_19.stl, ball_cup_25.stl, ball_cup_34.stl, ball_lower.stl, ball_lower_34.stl, mock_ball_19.stl]
2026-10-21 docs: 34mm cup print orientation
    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
2026-10-21 Blend the ball socket into the tray floor with a 10mm fillet
    Trimmed below the PCB, below each underside part and below the 34mm hood sweep.
    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
    [mock_tray_right.stl, tray_right.stl]
2026-10-21 Ball units swap as one piece: cup twist-locks into the tray socket (CCW 20deg)
    - Lugs at 60/180/300 on 19/25/34 cups, L-grooves with detent in the socket; old orientation key and screw bosses removed
    - Checks for insertion and twisting
    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
    [ball_cup_19.stl, ball_cup_25.stl, ball_cup_34.stl, mock_tray_right.stl, tray_right.stl]
2026-10-21 Full-height tray rim (flush with the plate top) all around; ball sits in a deck
    - Rim follows the PCB/plate/underside-part outline with a 0.6mm gap; outer top edge rounded
    - Battery screens removed (rim hides the battery); floating PCB on poron posts unchanged
    - Deck around the ball cut back for cups, retainers and the 34mm hood sweep
    - Power switch pocket extended through the rim under the cover roof
    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
    [mock_tray_left.stl, mock_tray_right.stl, tray_left.stl, tray_right.stl]
2026-10-21 Back to the floating island: low rim with shadow gap, inner lip, separate ball deck
    - Low rim (1.5mm under the PCB) all around plus a continuous inner lip under the PCB edge that hides the battery
    - Ball deck as a separate part (print in plate color): fills the PCB notch to plate height, aligned to the PCB rectangle, 1.5mm undercut, keel sits on the tray, one M2 screw from below; not used with 34mm
    - Checks for deck vs PCB/plate/keys/units/covers and seating
    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
    [ball_deck.stl, mock_deck.stl, mock_tray_left.stl, mock_tray_right.stl, tray_left.stl, tray_right.stl]
2026-10-21 Drop the ball deck; keep the floating island (low rim, shadow gap, inner lip)
    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
    [ball_deck.stl, mock_deck.stl, mock_tray_right.stl, tray_right.stl]
2026-10-21 Revert "Drop the ball deck; keep the floating island (low rim, shadow gap, inner lip)"
    This reverts commit e2ecc37aab6ddd1a5af831d539c62a691a1c8898.
    [ball_deck.stl, mock_deck.stl, mock_tray_right.stl, tray_right.stl]
2026-10-21 Lower the claw ring to just above the cup (below the ball equator); claws lengthened
    Tilt and 19/25/34mm swapping unchanged. Adds the in-grid placement proposal render for reference.
    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
    [ball_cover_19.stl, ball_cover_25.stl, mock_ball_19.stl, mock_ball_25.stl]
2026-10-21 Lower the 34mm hood top to just above the cup rim; hood claws lengthened
    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
    [ball_hood_34.stl, mock_ball_34.stl]
2026-10-21 Set ball tilt to 30 deg; deck keeps only the screwed corner piece; add 30 vs 0 deg comparison
    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
    [ball_deck.stl, mock_deck.stl, mock_tray_right.stl, tray_right.stl]
2026-10-21 Drop 34mm; sink the ball unit to the limit (33.1mm ball top for 25mm at 30 deg)
    - Unit back to OD 34 / bore 31; 34mm cup/hood removed
    - Sensor board corner chamfered 9mm (lowest corner), 3 cup legs, sensor room shaped to board/legs/connector
    - LOWER_SKIN 0.4; lift from pocket, room floor and cup ledge
    - Board clips moved off the leg sweep; bore top relieved for retainer lugs
    - Deck omitted when no screw position fits; tray clipped to its outline
    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
    [ball_cover_19.stl, ball_cover_25.stl, ball_cup_19.stl, ball_cup_25.stl, ball_cup_34.stl, ball_deck.stl, ball_hood_34.stl, mock_ball_19.stl]
2026-10-21 Base the sensor on PMW3610DM-SUDU + LM18-LSI (datasheet dims)
    - Sensor stack from the ball: lens 2.4 / PCB top ~5.75 / pin ref 8.35 / package back ~9.2
    - Custom sensor PCB outline with lens cutout; socket gets PCB pocket + package pit; clips on back/left edges
    - No cup legs (no room on the PCB during the twist lock); sinking limited by the package corner
    - Ball top 35.8mm (25mm, left-front 30deg)
    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
    [ball_cup_19.stl, ball_cup_25.stl, ball_deck.stl, mock_ball_19.stl, mock_ball_25.stl, mock_deck.stl, mock_tray_right.stl, tray_right.stl]
2026-10-21 Tilt the ball toward the front (270deg); claws at 0/90/180; PCB ball cut widened to the front
    Ball top 34.5mm (25mm) / 28.9mm (19mm). Checks pass at 20/30deg and with worst dims.
    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
    [ball_cover_19.stl, ball_cover_25.stl, ball_cut.dxf, ball_deck.stl, left.kicad_pcb, mock_ball_19.stl, mock_ball_25.stl, mock_deck.stl]
2026-10-21 Add current PCB top-view drawings (left/right)
    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
2026-10-22 Add concept image: ortholinear layout with 60-degree sensor ball unit
    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
2026-10-22 Add concept image of the dedicated 34mm ball case
    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
2026-10-22 Make ball units screw-removable modules with a shared seat; add concept image
    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
2026-10-22 Spec: fixed sensor base sized for 34mm, swap only the upper cup per ball size
    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
2026-10-22 Spec: fix the swappable cup with three M2 screws from the bottom
    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
2026-10-22 Spec: scroll wheel encoder in the left corner; add concept image
    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
2026-10-22 Spec: drop display, put XIAO and slide power switch on the top surface
    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
2026-10-22 Shrink tray: ball base forms the corner, 4mm rim (about 141x85mm per half)
    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
